threebod/mecanum_jog/README.md

# 麦克纳姆轮串口点动测试例程

## 当前代码检查（2026-10-13）

本次整理保留当前机构、路线和视觉参数，物理参数已由项目负责人确认完成实机验证。
离线检查通过：Keil 构建 0 错误、0 警告，配套上位机完整 CTest 38/38，MaixCAM Python 测试 52/52，
K230 Python 测试 40/40，以及固件契约、机构时序、云台运动和障碍停车独立测试。
本次未连接、烧录或驱动硬件；后文历史验证记录对应各自版本，以本节作为当前提交的软件检查结果。
构建输出、日志、相机 ZIP、Python 缓存和本地 Wi-Fi 配置不提交。K230 部署前将
`camera_code/K230/wifi_config.example.py` 复制为 `wifi_config.py`，填写本地 Wi-Fi 信息后上传开发板。

当前自动取放机构速度：水平轴 1000 RPM；云台夹持时峰值 220°/s（平滑起停），空载时 250°/s（等步长转动）。夹持状态按夹爪目标角度推定，张开至 90° 视为空载。`turretDps10=2200`，空载速度由主控切换为 2500；上位机云台输入上限同步为 2200，平台仍为 1800。动作文件 `夹取.json`、`放置.json`、`放置_升降600rpm无等待.json`、`10_粗加工回收xiugai.json` 已同步水平与云台参数。此段为当前速度，后文旧速度记录仅供历史对照。

新增独立“区域记忆避障跑图”：`avoid start 1|2 10..250`，上位机默认 30 RPM。K230 检出后停车确认、按区域记忆封路、退回并重新规划。到扫码点朝右停车扫码，收到结果后继续两轮底盘路线，不执行取放；K230 扫码后保持运行。部署、区域及标定见 [AVOIDANCE_TEST.md](AVOIDANCE_TEST.md)。

已加入地图两轮底盘路线、指定安全航点移动和 IMU 闭环旋转，支持蓝牙 `route auto 1|2 [rpm]` 连续跑完整路线、`route step 1|2 [rpm]` 逐点测试、`nav init 1|2` 初始化估计位置、`nav goto X Y [rpm]` 移动到安全航点、`turn L|R 90` 单独旋转和 `!` 急停。启动运动前先发 `arm`。首次使用请阅读 [ROUTE_TEST.md](ROUTE_TEST.md)。路线和导航位置均为速度积分估计，尚未接入地面定位、随机避障、扫码及抓取流程。

已增加同步距离测试、IMU 航向保持、单轮验向和四轮 CAN 查询。完整新增命令、接线及落地测试步骤见 [STRAIGHT_TEST.md](STRAIGHT_TEST.md)。原有命令保留；新版本运动期间会拒绝叠加运动命令，等待测试窗口结束或先停车。

本例程用于架空状态下检查 1～4 号麦轮电机的编号、方向和四轮联动。工程复用 `yyb_stm32` 的 STM32F407ZG 标准外设库、CAN 和 Emm_V5 驱动，不会修改参考工程。

## 硬件与通信

- 主控：STM32F407ZG，系统时钟 168 MHz
- 电机总线：CAN1，PA11(RX)、PA12(TX)，500 kbit/s
- 蓝牙命令串口：UART5，PC12(TX)、PD2(RX)，115200、8N1
- 淘晶驰 T1 串口屏：USART6，PC6(TX) 接屏幕 RX、PC7(RX) 接屏幕 TX，115200、8N1，3.3 V TTL 并共地
- 麦轮电机地址：1、2、3、4；辅助机构诊断地址：5、6
- 舵机 2/3/4：PA1/PA2/PA3，对应 TIM2_CH2/CH3/CH4

HC-05 与核心板交叉连接并共地：

| HC-05 | STM32F407ZG |
| --- | --- |
| TXD | PD2 / UART5_RX |
| RXD | PC12 / UART5_TX |
| GND | GND |

HC-05 数据串口应配置为 115200、1 停止位、无校验，常见完整 AT 固件对应 `AT+UART=115200,0,0`。模块 RXD 必须使用 3.3 V 逻辑电平；若底板没有输入分压，不要输入 5 V 串口电平。

> 软件停止不能替代硬件急停。首次运行必须架空四个轮子，确认人员可以立即断开电机电源，并且不要直接运行完整整车流程。

## 使用方法

使用 Keil MDK 打开 `MecanumJog.uvprojx`，通过有线下载器编译并下载。配对 HC-05 后，在电脑或手机上打开对应的蓝牙串口。命令除 `!` 外均以回车或换行结束：

上位机“路线编辑”页使用新增的 `move W|S|A|D 距离mm RPM` 相对移动指令，
距离 1～2400 mm、速度 10～250 RPM，横移受 `route tune` 的横移速度上限限制。
方向相对当前车头，保持启动时 IMU 航向，沿用现有前后／横移比例进行速度积分估算。
启动与完成分别反馈 `MOVE RUN dir=... distance_mm=... rpm=...` 和
`MOVE DONE dir=... distance_mm=...`；完成只停止底盘，不清除机构初始化。
单独转向成功也保留机构初始化，但会使旧地图导航位置无效。
`mech status` 增加 `MECH SERVOS gripper_mdeg=... platform_mdeg=... turret_mdeg=... moving=...`，
供路线动作组核对初始状态。故障、手动停止及心跳超时仍停止并清理全局运动状态。

```text
arm       授权下一次运动命令，执行一次后自动取消授权
disable   停止并失能 1～6 号电机，无需 arm
motor N D 5/6号电机按方向0/1短点动，必须先 arm
auxmove N D R A 5/6号电机按相对距离移动，D单位0.1mm，必须先 arm
cancheck N 查询1～6号电机CAN状态并打印原始回包，无需 arm
servo N A 将舵机 N 移到电气角度 A，无需 arm
W / w     前进点动
S / s     后退点动
A / a     左移点动
D / d     右移点动
X / x     停止 1～6 号电机和舵机缓动，并取消授权
stop      停止 1～6 号电机和舵机缓动，并取消授权
!         无需回车，立即请求电机与舵机缓动紧急停止
help      显示命令帮助
nav init 1|2       以对应启停区初始化估计位置，要求空闲且 IMU 新鲜
nav goto X Y [rpm] 沿安全通道移动到指定坐标，速度10～250 RPM，默认200，必须先arm
nav status         查询导航有效性、估计位置和目标
route tune F L T [V]   空闲时设置纵向/横向比例、转向及横移上限；比例5000～15000，转速10～250 RPM
route scale N      兼容命令：仅设置横移比例
route rawpick 1|2 [rpm]  首轮原料区停车，按绿、黄、浅蓝顺序夹取入槽，必须先arm
task CCC+PPP+CCC+PPP    下发两批颜色顺序和位置，运行中拒绝修改，重启后失效
pid get            读取导航/路线平移航向 PID 的 RAM 当前值
pid set KP KI KD   停车后设置航向 PID，三个参数均为实际增益的100倍
vision align material N  对准颜色1～6的物料，必须先arm且已完成视觉标定
vision sample material N ID  只读指定颜色1～6的稳定中心；ID为1～65535，不移动或夹取
vision scale material F R  空闲且arm后设置物料前后、左右比例；F/R为毫米/像素乘1000，范围50～2000
vision pick material N   底盘静止时识别颜色N，成功后执行单件夹取动作；必须先arm、初始化机构并确认当前姿态为(0,0,2720)
vision align ring N      对准物理圆环1～3，必须先arm且已完成视觉标定
vision scale ring N F R  空闲且arm后设置圆环N的前后、左右比例；F/R为毫米/像素乘1000，范围50～2000
vision pause/status      停止并接管/查询视觉状态
vision jog F R RPM       车体前/右方向各-20～20mm，10～30RPM，必须先arm
mech init H L T    人工确认当前机构姿态，单位为0.1 mm/0.1°，无需arm
mech pose H L T HR HA LR LA TS  移动到机构姿态（升降0～1500 ×0.1 mm），必须先arm
mech status        查询机构估计姿态
```

`mech pose` 和 `auxmove` 对 5/6 号升降、平推电机的可设上限为 1200 RPM、加速度参数 200，与上位机动作录入和定距调试界面一致。现有自动取放动作表仍保留原速度；高转速应先在架空、可急停条件下分轴测试，实际到位仍需人工核对。

`nav goto` 接受地图范围内、车体按 300×300 mm 计算后仍满足净空的任意整数坐标。规划器会从当前估计位置接入静态安全航点图，并以水平或垂直安全线段到达目标；障碍区、边界净空不足或无法通过安全通道到达的坐标会返回 `ERR NAV:`。地图点击仍可吸附既有安全航点，也可在上位机输入精确坐标。导航运行期间约每 200 ms 输出一次 `NAV POS`；正常完成输出 `NAV DONE`。`stop`、`!`、心跳超时、CAN/IMU 故障以及其他手动底盘动作都会使估计位置失效，之后必须把车放回启停区并重新执行 `nav init 1|2`。

`route start`、`route step`、`route auto`、`route rawpick`、`route mission`及PC9启动分别使用 `route_plan.h` 的 `routeDistanceZone1` 和 `routeDistanceZone2` 两套完整距离表：每段仅保存向上/向右的有符号距离、出发朝向、到达朝向和工位事件，不使用全图航点。距离按下发转速、时间和前进/横移标定比例估算；IMU负责朝向，视觉仍负责工位局部对准。上位机显示每段已走/目标距离，不用距离消息更新地图位置。两套表各自包含完整20段的距离、朝向和工位事件，`routeDistanceLeg` 只按起点选择对应表，不再叠加共用表或起点修正；修改某套的距离和转向只影响该套。底层运动控制与取放流程共用。独立的人工 `nav goto` 功能仍使用地图导航，与两轮距离任务分开。

`route auto 1|2 [rpm]` 是仅控制底盘的完整跑图命令，依次经过二维码区、第一轮原料/粗加工/暂存、第二轮原料/粗加工/暂存并返回对应启停区。按固定的方向、距离和朝向逐段执行，每段从0累计已走距离，不读取或重置全图X/Y。运行时约每 200 ms 输出 `ROUTE DIST`（段号、地图方向、目标距离、已走距离、朝向和状态），到达作业点输出 `ROUTE STAGE`，结束输出 `ROUTE DONE mode=DISTANCE`；它不会执行扫码、抓取或其他机械动作。

路线与导航按车头朝向判断车体横移并应用横移转速上限：车头朝上/下时沿地图X移动属于横移，朝左/右时沿地图Y移动属于横移。两轮原料区到粗加工区均先转为车头朝下，向前直行到站后转为车头朝右；两轮完整取放任务均将取料微调的反向补偿与沿地图向右退出50毫米合成一次移动。该段直行使用前进比例及请求速度，不受横移上限约束；其他横移默认上限150 RPM，低于上限的请求速度保持原值。

`route rawpick 1|2 [rpm]` 是原料区联调命令。出发前确认机构实际位于水平0、升降0、转台65°、夹爪闭合35°、平台1槽，并执行 `mech init 0 0 650`；核对物料对准方向和抓取锚点后发送 `arm`、`vision scale material 640 673`，再发送 `arm` 和路线命令，也可在上位机“场地定位”页点击“路线取料联调（RAW_1 三件）”。未应用物料比例时路线拒绝启动，比例仅保存在 RAM。路线到达 `RAW_1`、完成转向后停车；依次抓取绿(4)、黄(2)、浅蓝(6)，分别放入平台1、2、3槽。每件先将水平轴收至-770、转台到272°并保持升降0，再同时开始相机识别与升降轴下降500（50 mm）；升降运动结束并重新确认目标后才夹取，相机按v1.0.9采用附件六色阈值及原面积范围，取最大色块，取消物料质量及贴边筛选；连续10个有效帧且各轴中心波动不超过8像素即稳定，无最低500ms等待，回传这10帧中心中位数及实际颜色。每轮先用任意颜色1～6中面积最大的物料校准，首次及后续均以画面X轴±14像素为范围，Y轴换算本次夹取的水平轴补偿；X超限时只按原X映射修正底盘，停稳300ms后重新请求复检。首次对准完成后才等待绿色，重新确认连续10帧静止且X轴进入范围，一轮合格结果即可夹取；后两件依次等待黄色和浅蓝色，同样按X轴±14像素确认，X超限则再次校准；每件动作完成后才标记该颜色已收集。目标移动或识别不稳定时继续等待，不调整车辆或执行夹取；通信超时、机构或IMU/CAN故障会停止流程。第三件动作结束输出 `ROUTE RAWPICK state=DONE color=0 slot=0`，车辆仍停在 `RAW_1`，人工检查后发送 `route next` 或点击上位机“确认并继续路线”才继续；三件未完成时拒绝继续。`stop`、`!` 或故障后不能直接续行，须核实机构位置并重新初始化。对准只依据物料中心，不验证夹持结果；每段已走距离仍按转速和时间估计，没有地面距离反馈。

`route mission 1|2 [rpm]` 是独立的两轮取放任务，保留上述两个联调命令的行为。上电自动向云台（舵机4）输出65°指令，同时向夹爪（舵机2）输出闭合35°指令；按用户确认的上电物理零位，固件自动初始化水平0、升降0、转台65°，同时将平台指令到26°并准备PC9离线启动；默认200 RPM，物料保持前后640、左右673，圆环2采用实测前后1111、左右1143的比例。到第一次取料区RAW_1后，准备动作将空载云台以200°/s匀速转至272°并将水平轴收至-770，完成观察姿态后，同时请求识别物料和下降升降轴至500（50 mm），实际抓取动作会先张开夹爪至90°。升降未结束时继续识别，结束后重新确认目标才启动夹取。后续伸出保持升降500，不再先回到0再下降，抓取后仍抬升至0；夹取动作表共12步，`动作组/夹取.json`同步更新。跑图入口允许夹爪闭合35°或张开90°，平台仍须为26°。兼容已初始化为272°的启动姿态；第二轮仍使用原272°姿态。通过上位机点击“开始两轮完整取放”时，会先下发任务码并等待对应的TASK SET确认，再依次指令夹爪90°（270°/s）、平台26°，等待舵机到位，再分别应用物料默认比例640/673和视觉页当前圆环2比例，收到两次主控确认后才授权发送任务命令；直接用串口发送 `route mission` 时无需预先发送任务码；可使用上电零位、舵机和视觉比例准备，启动前仍需 `arm`。舵机角度检查只依据已发指令，不是实物位置反馈。路线在二维码点至少停稳1秒，并持续等待合法四组任务码；K230扫码结果通过USART3接收，首个合法码决定两轮取放顺序与放置位置，同时转发给上位机和串口屏。主控缓存本次上电或本次任务接近扫码站前收到的首个合法扫码结果，兼容K230单次发送后停止；到站后采用并消耗缓存，至少停车1秒后继续。非法码不覆盖缓存，任务停止或结束清除缓存，不复用上一任务。第一、三组任务码分别决定两批的颜色和抓取顺序，三件依次放入平台槽1/2/3。每轮先用任意颜色1～6中面积最大的物料校准，无需等待该批首件颜色；首次及指定颜色阶段均采用X轴±14像素范围，Y轴只补偿水平电机的夹取位置。任意颜色对准完成后按任务码顺序请求指定颜色，每件重新确认连续10帧静止且X坐标进入范围，一轮合格结果即可夹取；超限时按标定换算完整移动，停稳300ms后以新token复检，最多12次修正。物料和圆环识别不设总等待时间：未找到或未稳定时持续等待并重新请求，圆环还检查质量；直到识别满足条件或人工停止。摄像头通信仍保留单次请求1800 ms、连续三次无回包停止的故障检查；累计微调距离不设上限，最多12次迭代限制保留。从取料区前往粗加工区的向下连续路段：两轮均为1720 mm；两轮均走左侧通道，下移结束转向右再前进860 mm到粗加工区。每段从0独立累计已走距离。两次粗加工区先将水平轴收至-770，停稳后用圆环2视觉对准，再执行取自 `动作组/放置_升降600rpm无等待.json` 的三件放置动作（按文件内容使用升降1000 RPM、加速度200、水平500 RPM、加速度200、转台180°/s，无额外等待），三件放置深度均为1300（0.1 mm），第三件松开夹爪后，保持原位直接夹紧，再抬升开始回收，不再先抬升再下降；三件全部放置后先在最后一件所在环抬升，再按该批任务码顺序回收三件，以相同速度和对应落点1300/1300/1300（0.1 mm）取回到各自原料盘槽，全部回收后先抬升并将水平轴收回至0，夹爪随水平轴撤回，再将转台直接转回65°；两轮暂存区同样先将水平轴收至-770；第一轮停稳后用圆环2视觉对准，第二轮优先对准圆环中心并跳过数字识别，多个圆环时选择最靠近第一层中间指定颜色物料中心的圆环；首次识别失败再对准该物料中心（沿用圆环2的ROI、锚点和比例，须实测物料高度带来的偏差），成功后才用同一组三件放置姿态，第一轮三个落点的升降深度统一为1300（0.1 mm）；两轮粗加工及两层暂存均按对应批次任务码的物料顺序放置，每次依次从平台槽1→2→3取料，第一轮粗加工和暂存使用第二组位置，第二轮粗加工使用第四组位置，第二轮暂存按第二批颜色匹配第一层同色物料所在圆环；转台角度306.5°/265.7°/232°分别对应圆环1/2/3，三个落点统一为650（0.1 mm），较第一层少下降65 mm。两轮原料区均记录视觉对准相对于对准前停车位置的累计前后及左右位移；第三件放入平台松爪后，先抬升，随后直接将机构收回至水平0、升降0、转台65°，不再中途转到272°；底盘保持停车，等待转台到位后才报告取料完成；后续按现有路线继续。两轮取料后只将视觉对准累计位移中的地图上下分量反向归位，以15 RPM下发并输出RAW_EXIT_VERTICAL阶段；无上下偏移时直接继续，不再额外右移50 mm。左右归位量合并到后续沿地图向左830 mm的路段：取料时车头朝左，实际左移距离为830 mm减去累计车体前进偏移（按整数毫米取整）。左移后停车转为车头朝下，沿地图向下1720 mm（本次减少20 mm），再停车转为车头朝右，沿地图向右860 mm到对应轮次粗加工区。两轮均取消额外右移50 mm。回位依赖已发位移指令的累计估算，没有独立位置反馈，实际精度须实测。粗加工和暂存区在视觉对准成功后，以当前位置作为该区域标准位置，作业结束收回机构后不再进行底盘微调回退，直接执行下一段原定相对路线；粗加工到暂存区先保持车头朝右，直接沿地图向左（X负方向）连续移动860 mm，走完后停稳转为车头朝地图下方（地图后方），随后沿地图向上后退850 mm至暂存区，走完后保持朝下直接作业，机械臂位于车体右侧、面向地图左侧；两轮均生效，视觉微调不计入下一段距离，后续距离从各区域完成作业的位置重新累计。扫码区完成扫码后，两套路线均先原地将车头从朝右转为朝上，再沿地图向上直行：启停区1为830 mm，启停区2为825 mm；走完停稳后再将车头转为朝左；转向停稳后到第一次取料区：启停区1出发第一段左移为200 mm，扫码后到第一次取料区左移从930 mm减少至900 mm，两段合计左移1100 mm；启停区2扫码后到第一次取料区同样向左走900 mm，直接开始取料，不再在物料区转向，也不额外后退100 mm；后续相对距离保持原值。第一轮暂存返回第二次原料区RAW_2时，先保持车头朝下、沿地图向上连续移动：启停区1出发为880 mm（较原840 mm累计增加40 mm），启停区2出发为850 mm（仅区2较此前840 mm增加10 mm），走完停稳并转为车头朝左，再沿地图向右连续移动850 mm（保留原有向右多走50 mm），保持朝左开始第二轮取料；抵达后按下一段独立距离继续执行。取料、粗加工放置与回收、暂存放置的物料平台速度统一为180°/s，平台转动与机构动作并行，只在夹爪下降到平台取放前等待平台指令转动完成，新平台转动不会覆盖尚未完成的上一条转动。固件输出 `ROUTE MISSION phase=... station=...`；圆环或第二轮暂存中间物料未识别、未稳定时持续重新请求，圆环还检查质量；不盲目移动；通信超时、对准超限、动作、回位或传感器故障会取消任务，不能原地续跑。取回及暂存动作由现有姿态推导，必须先按台架分段验证电机方向、机械净空、夹持和急停，之后才可低速运行整圈；动作完成消息不代表实物取放成功。

扫码结果也会从 USART6 发往淘晶驰 T1。按 `test/lcd_ttl` 的测试界面，在屏幕工程的 `page0` 页面创建文本控件 `t0`，将 `page0` 设为启动页、项目字符编码设为 UTF-8、屏幕波特率设为 115200，并给控件足够的字符容量和字库。仓库目前只有 `test/lcd_ttl` 的 MCU 测试程序，没有可烧录的屏幕 HMI 工程，屏幕侧仍需在淘晶驰编辑器完成上述设置。主控收到 `QR:<内容>\n` 后发送 `page0.t0.txt="<内容>"`，末尾是三个字节 `FF FF FF`；结果同时用于扫码点的四组任务码校验和任务选择。若沿用只支持 GB2312 的屏幕工程，ASCII 内容可以显示，中文 UTF-8 内容需要先把屏幕工程改为 UTF-8。二维码内的引号、反斜杠和 `FF` 字节会在屏幕文本中替换为 `?`，上位机收到的原始结果不变。须在实机确认屏幕页面、控件名、波特率和供电电平。

完整四组任务码在 `t0` 中固定分两行显示，第一行为前两组及末尾加号（如 `156+123+`），第二行为后两组（如 `516+231`）。主控只在发给屏幕的文本中插入 CR/LF，扫码缓存、上位机日志和任务解析仍使用原始15字符任务码。屏幕 `t0` 的宽高需容纳两行大字，字库需包含数字与加号。

同一屏幕页面还需创建文本控件 `t1`、`t2`，分别显示 `正确抓取数：N` 和 `正确放置数：N`；三项控件均设为全局，`t0.txt_maxl` 建议48，`t1/t2.txt_maxl` 建议32，UTF-8字库须包含数字、加号及计数文字。主控上电和成功启动新的两轮完整任务时清零计数，在对应夹爪动作完成后逐件更新，停止、故障取消或任务结束时保留已有计数。按用户确认的动作完成口径，原料抓取和粗加工回收计入抓取，粗加工及暂存区落料计入放置，平台中转及手动调试动作不计；完整两轮为抓取12次、放置12次。当前没有夹持或落料成功反馈，屏幕文字沿用比赛界面，但这些数值只代表动作完成，不能证明实际取放正确。任务码继续由 `t0` 显示，比赛中需持续可见，数字实屏字高应至少12毫米；字体、排版和实机显示需在屏幕工程中确认。

若取料路线启动时报告机构姿态错误，先发送 `mech status`：`MECH INVALID` 表示需要在人工确认实际姿态后重新初始化；`MECH POS` 的 `h/l/t` 必须为 `0/0/650`（也兼容原来的 `0/0/2720`）。舵机仍在运动时等待 `SERVO DONE` 后再试。不要为了通过检查，把未知实际位置直接声明为初始姿态。

导航/路线平移航向 PID 可在上位机“临时调试”页读取和写入，也可用 `pid get`、`pid set 200 25 12`。Kp 范围 0～10.00，Ki/Kd 范围 0～5.00，纠偏输出仍限于 ±12 RPM；写入时底盘及机构必须停稳，固件会回报当前值。参数只保存在 RAM，复位后恢复 2.00/0.25/0.12。平移期间约每 200 ms 输出 `PID TRACE target_cdeg=... actual_cdeg=... output_rpm=...`，上位机据此绘制目标/实际航向与纠偏输出曲线。原地转向和 `straight` 命令仍使用原有控制器。

`pid move A|D 2000 20` 用当前航向作目标，以导航航向 PID 限时向左/右横移并输出相同的曲线数据；需先 `arm`，时间 1000～5000 ms、速度 10 RPM 至当前横移上限。到时会停车，移动距离不作测量。上位机“临时调试”页提供左右按钮和时间、速度设置。

粗加工回收保留 `动作组/10_粗加工回收xiugai.json` 的单件抬升、转向和平台放回姿态，完整任务按任务码顺序生成，共37步，两轮均生效。
圆环角度306.5°、265.7°、232°分别对应物理圆环1、2、3。圆环1水平目标位置为55（5.5 mm），较此前向前0.5 mm，角度306.5°；圆环2角度从266°减少0.3°至265.7°；圆环3水平目标位置为435（43.5 mm），较此前向前0.5 mm，粗加工放置、回收及两层暂存放置同步使用新落点。粗加工放置、回收及两层暂存放置均按对应批次任务码的物料顺序执行，平台槽依次为1→2→3。粗加工三件全部放置完成后，先在最后一件所在环原位抬升至0，再移动到任务首件所在环下降夹取，三件均返回原平台槽。每件抬升后先保持当前水平位置将云台转向132°，再将水平轴收至该轮的平台放回位置；三个平台放回深度均为300（0.1 mm）。第一轮三件的平台水平位置为-450（较此前-500少回退5 mm）；第二轮三件按指定位置-470（-47 mm）放回。下降至300、松爪及松爪后抬升阶段均保持对应轮次的水平位置。下降到平台前仍等待平台转动完成。
结束时先在132°收回水平轴至0，再转回65°。入口为任务第三件放置后原位，水平位置和云台角度由该件目标环确定，升降1300、夹爪张开。

取料、圆环及码垛观察的水平位置统一从-720再调整为-770，即再回退50（5 mm），较原-500累计回退27 mm；竖直坐标不变。相机让位后抓取和放置仍使用原来的绝对目标坐标，不把平台取放位置整体平移。

## 上位机任务码

任务码为 `CCC+PPP+CCC+PPP`，严格四组三位数。第一、三组为两批的颜色和搬运顺序；第二组为第一批在粗加工区和暂存区的位置，第四组仅为第二批在粗加工区的位置，每组必须为1、2、3的排列。第二批暂存按第一层颜色位置同色码垛，不使用第四组；两批颜色须能一一匹配，否则在码垛前停止并报告 `mission_stack_colors`。颜色：红1、黄2、蓝3、绿4、黑5、浅蓝6。圆环1的角度最大（306.5°），其次是圆环2（265.7°）、圆环3（232°）。

例如 `156+123+516+231`：第一批红、黑、浅蓝依次进入平台槽1/2/3，粗加工放置、回收及第一层暂存均按环1→2→3执行；第二批黑、红、浅蓝依次进入槽1/2/3，粗加工放置和回收均按环2→3→1执行；第二层暂存按黑、红、浅蓝顺序，依次码垛到同色的环2→1→3。所有阶段均依次选择槽1→2→3。暂存第二批使用第二层的650深度。粗加工回收保持原槽与物料对应关系。

上位机“场地定位”页填写任务码后点击“开始两轮完整取放”，会先发送 `task 156+123+516+231`，仅在收到相同任务码的 `TASK SET code=156+123+516+231` 后继续舵机、视觉比例和路线启动准备。非法格式或运行中修改返回 `ERR TASK`，不覆盖当前有效任务。任务只存在RAM，启动时清除上位机任务的有效标志，但保留本次收到的合法扫码缓存；到扫码点时采用并消耗缓存，若无缓存则等待新合法扫码码后继续。扫码确认覆盖预先下发的任务，不使用上位机任务作为扫码失败时的后备。

## PC9按键启动完整任务

PC9配置为GPIO输入、内部上拉；按键一端接PC9，另一端接主控GND。按下为低电平，按下和松开均进行30 ms消抖。短按不足1秒并松开启动启停区1；长按满1秒立即启动启停区2，继续长按和随后的松开不重复启动。上电时按键已经接地不会启动，须先松开再按；运行中的按键事件不会排队到任务结束后执行。

上电后无需连接上位机：水平/升降轴按用户确认的物理零位初始化为0，云台指令65°、夹爪35°、平台26°，物料和圆环2比例采用前后640、左右673，默认200 RPM。舵机指令运动结束后按PC9即可启动完整任务，到扫码点等待四组任务码（例如 `156+123+516+231`）。IMU必须新鲜、CAN必须健康，按键仅授权本次任务启动。

终端 `arm`、`route button <rpm>` 仍可重新准备PC9并选择10～250 RPM速度；上位机仍可覆盖视觉比例。PC9准备及按键启动任务无需主机心跳；上位机直接发送 `route mission` 启动的任务仍保留现有心跳保护。停止、失能、急停、CAN故障会取消准备，运行中IMU/CAN/视觉通信与动作故障保护保持。任务结束或中止后不会自动重新准备；须核实实际姿态、恢复零位后重新准备或重新上电，禁止原地盲目续跑。

软件检查已覆盖GPIO上拉设置、消抖、短／长按分区、启动前无底盘使能、长按不重启、上电按住、启动状态变化和毫秒计时回绕；接线、按键输入电平及两个启停区的实车完整流程尚未验证。

## 回启停区与颜色反馈（2026-10-08）

第二轮暂存结束后不再先进入右侧通道。启停区1先保持车头朝下、沿地图向上880 mm，停稳转为朝右，再向右前进1700 mm、保持朝右向上横移170 mm、向右前进150 mm。启停区2先保持朝下、沿地图向下850 mm，停稳转为朝右，再向右前进1700 mm、保持朝右向下横移200 mm、向右前进150 mm。两套路线保留四段距离与顺序，分别返回原启停区，结束时车头朝右。每段独立累计距离，实机净空和停车位置须现场验证。

取料准备和等待阶段反馈当前指定颜色及槽位；夹取和单件完成反馈实际颜色及槽位。三件完成后转台回到65°并等待到位，随后反馈 `ROUTE RAWPICK state=DONE color=<该批第三件颜色> slot=3`，原料联调仍须人工确认后继续，完整任务自动继续。物料请求的 `value[6]` 为允许颜色位掩码（颜色N对应位N-1），结果 `value[5]` 为实际颜色；旧相机回传未知颜色时主控只等待，不猜测槽位。STM32与MaixCAM2程序必须同步更新；本次未改动人工确认版路线JSON。

实机验证先检查方向、急停、机构净空，再按取料、粗加工、暂存和回程分段低速测试。记录首次修正前后偏差和补调次数，检查任意颜色可用于首次对准、任务指定颜色超差会重新对准、非当前指定颜色不会触发运动或抓取，以及任务槽位映射；软件测试通过不代表实物夹取或一次到位已验证。

## 视觉微调

取料区坐标校验：画面X偏差 `du=u-160` 保持现有±14像素容差，范围内底盘不动，超限只沿原X映射修正底盘并停稳复检。画面Y偏差 `dv=v-120` 不再驱动底盘，按物料Y比例 `R` 换算水平轴：`补偿(mm)=-R×dv/1000`（R为毫米/像素乘1000），`夹取目标(0.1mm)=-200+round(-R×dv/100)`。例如R=673、dv=+35时目标为-436（-43.6mm），画面偏下减少伸出。只使用升降结束后、当前指定颜色的最新稳定样本；首次任意颜色对齐不执行抓取补偿。补偿应用于夹取伸出、夹紧后抬升，以及抬升后转向平台时保持的水平位置；平台放回坐标和末尾复位保持原值，各件独立计算。目标超过水平轴-122.0～65.0mm范围时输出 `PICK_HORIZONTAL_RANGE` 并停止，不夹取、不截断位移。日志 `VISION PICK OFFSET` 输出dv、补偿及目标（单位0.1mm）。仅两轮任务及route rawpick的取料区生效，单件固定夹取测试、普通视觉对准、圆环和暂存流程保持原逻辑。方向按用户确认，实机效果仍需低速验证。

上位机也支持物料比例自动标定：在“视觉微调”选择物料及固定颜色，先将机构置于实际取料观察姿态，保持该颜色的单个物料静止可见，确认各方向20 mm净空后点击“自动标定物料比例”。机构姿态须人工准备，程序不夹取；前后、左右各往返20 mm（15 RPM），每步停稳300 ms。新增 `vision sample material COLOR ID` 只读采样，回包包含样本ID和颜色，稳定性及指定颜色检查通过才采样，质量值仅作诊断。比例经主控确认后独立应用，完整任务不会覆盖成默认物料比例；断电恢复默认值。此功能需要配套更新主控固件，摄像头程序无需因本功能更新，尚未实机验证。

上位机支持圆环 2 自动标定：在实际识别姿态下，以 15 RPM 前后及左右各往返 20 mm；每次移动完成停稳 300 ms，
再通过 `vision sample ring 2 ID`（ID 为 1～65535）读取稳定中心。主控回复
`VISION MEASURE id=... ring=2 token=... du=... dv=... quality=...`，不使用旧比例、不执行视觉矫正。
采样结束为 IDLE，可执行带 `arm` 的 `vision jog` 探测；最后一次回位采样后，上位机核对方向、往返偏差和两轴耦合，
用往返像素变化平均值换算两轴比例，再通过 `vision scale ring 2 F R` 应用，必须收到对应值确认才完成。
采样保留相机 token 校验及质量/稳定性检查；异常或超时停止，标定值只保存在 RAM。
采样连续 3 次未确认才停止，每次重试使用新相机 token；上位机按往返均值检查两轴耦合，并保留 3 像素回位门槛。
圆环2正式默认比例定义在 `vision_defaults.h`：1.111 / 1.143 mm/像素；固件离线上电及上位机圆环2输入使用同一默认值，物料保持0.640 / 0.673。在线标定可覆盖本次上电参数，重启恢复正式默认值。相机坐标仍为 320×240 协议坐标，比例变更本身不需要更新相机程序。自动标定实机效果尚未验证。

MaixCAM通过UART4连接：STM32 PC10(TX)接MaixCAM2 A22(RX)、PC11(RX)接MaixCAM2 A21(TX)，9600、8N1、3.3V逻辑并共地。部署 `camera_code` 整个目录并运行其中的 `main.py`。UART5仍用于上位机，USART2仍用于IMU。

自动微调按“停车识别—完整修正—停稳复检”执行；取消20mm拆步，首次直接执行标定换算出的完整位移，复检超出当前容差时重新补调。前后及左右位移绝对值累计之和不设上限，最多12次，取料首次任意颜色校准、修正后及后两件夹取确认统一采用X轴±14像素范围，一轮静止结果即可确认；X超限时重新对准，Y轴换算水平轴夹取位置，不驱动底盘。圆环及暂存对准仍允许各5mm误差，连续两次确认满足阈值才完成；完整修正不会因累计移动超过100mm而停止或截断。相机帧使用30字节CRC协议和请求token，过期、重复、无效或非稳定结果均不能触发运动。`stop`、`!`、心跳超时、IMU/CAN异常和`vision pause`都会停止闭环。视觉或人工小步会使地图积分位置失效，之后必须重新`nav init`。

上电离线准备会启用物料和圆环2的当前比例；圆环1、3仍须手动标定。圆环可在上位机“视觉微调”页分别调整前后、左右毫米/像素比例，再点击“应用当前圆环比例”；主控确认后，该圆环以画面中心 `(160,120)` 为目标，按 `前后=-F×du/1000`、`左右=-R×dv/1000` 换算。两个轴的对应关系与符号来自圆环2的连续移动日志，尚未通过纯方向点动独立验证；当前未补偿轴间交叉影响。圆环2默认采用用户实测的 `F=1111`、`R=1143`；圆环1、3界面初值仍为 `F=640`、`R=673`，并非圆环1、3的独立实测值，只适合低速小步验证；请先核对车体方向、急停和每步位移。物料比例也暂参考这组数据，须核实物料相机视角下的方向、比例以及画面中心是否对应实际抓取点；最终应按 [camera_code/README.md](camera_code/README.md) 做物料九点标定，必要时修改 `vision_config.h` 中的 ROI、锚点及交叉项。在线修改的比例只保存在主控 RAM 中；重启恢复离线默认比例：物料前后640、左右673，圆环2前后1111、左右1143。未应用时固件返回 `VISION ERROR reason=CALIBRATION_INVALID` 或拒绝启动取料路线。每个目标仍须保证相机能唯一识别。不得用零矩阵解锁。

单件原料夹取测试使用上位机“视觉微调”页选择颜色，再点“识别指定颜色并夹取”（或发送 `arm`、`vision pick material N`）。底盘须已停车且路线已退出；机构先人工放到 `动作组/夹取.json` 的初始姿态：水平0、升降0、转台272°、夹爪张开90°、平台位置1，并执行 `mech init 0 0 2720`。主控先把水平轴收至 -770（-77 mm），再同时请求相机稳定识别所选颜色和下降升降轴至500（50 mm）；升降结束并重新确认指定颜色的静止目标后才执行 `raw_pick_action.h` 中取自该 JSON 的固定单件动作表。测试时须人工将原料放在这套动作能夹到的位置；检测只确认颜色存在，不校验物料是否位于夹爪抓取点，也没有夹持力或抬起确认。`VISION STATE state=PICK_DONE` 只表示动作指令结束，须人工检查是否夹到。识别失败、超时、暂停或急停均不启动后续夹取；中断后机构位置失效，需人工核实再初始化。单件指定颜色测试命令保持不变；本版任务取料首次对准请求任意颜色，对准完成后的夹取阶段仅请求当前指定颜色；相机需支持现有允许颜色掩码及实际颜色回传。

地图移动距离仍是开环估算。`route_plan.h` 的 `ROUTE_FORWARD_SCALE` 与
`ROUTE_LATERAL_SCALE` 分别标定前后和横移。100 RPM、横移比例90%的6次中心点测试中，
车体右侧到场地右边界均值为103.9 cm（理论105 cm），因此默认横移比例改为90%。2026-10-14确认
`line W 500 120` 使用9.9脉冲/mm后实测约500 mm；正式程序按3200脉冲/转、理论轮周314.159265 mm
换算，纵向默认比例设为102.89%（3200 / 9.9 / 314.159265），用于路线、相对移动及视觉微调的前后位移。
上位机“临时调试”页同步采用102.89%。该结果来自前进120 RPM，后退和其他速度仍须复测。
当前路线和导航行驶默认200 RPM，横移默认上限为150 RPM，转向默认上限为230 RPM；路线和导航可设10～250 RPM；原90%横移比例取自100 RPM 测试，需按当前轮型和转速重新实测。更换地面、轮胎、负载或平移转速后必须重新实测。
原地转向参考 `yyb_stm32` 的两阶段PID：大误差采用KP=2、KI=0、KD=0.8，误差进入15°内采用KP=2、KI=0.05、KD=0.4，积分贡献限幅±7 RPM。按参考工程50 ms周期换算当前IMU采样间隔，同一IMU样本不重复积分或微分。加速保留90 RPM/s缓变，减速及时更新，反向纠偏先清除旧方向速度；进入2°误差后停车，保留3.5°退出阈值和200 ms稳定检查。参数为参考初值，超调改善仍需实机验证。
路线到达有任务的站点后，先按出发时保存的航向基准校正角度，再进入视觉微调或站点动作；即使方向编号不变也执行检查。到站校正要求误差连续保持在±1°内200 ms，最后一次IMU采样必须覆盖这段稳定时间，重复使用旧样本不能判定完成。超差重新调整，IMU失效或转向超时沿用故障停车流程。这里不发送陀螺仪归零命令；过渡点和手动转向保持原判定。±1°为本次软件目标，须实机验证能否稳定达到。

上位机“临时调试”页可发送 `route tune F L T V` 同时调整纵向比例、横向比例、转向上限及横移上限；旧的三参数命令保持当前横移上限。设置仅写入 RAM，重启恢复默认值。
运动期间会被拒绝；横移上限也用于 `pid move A|D`。

机构命令中的 `H/L/T` 分别是6号水平位置、5号升降位置和转台角度，单位均为0.1；
`HR/HA/LR/LA/TS` 分别是水平转速/加速、升降转速/加速和转台速度（0.1°/s）。
水平范围为-122.0～65.0 mm，升降为0～150.0 mm，转台为0～360.0°；水平电机速度
10～1200 RPM、加速1～200；升降电机速度10～2000 RPM、加速1～240，转台速度1～180°/s。移动期间约每200 ms输出估计的
`MECH POS`，完成输出`MECH DONE`。该位置没有传感器校验；停止、急停、心跳超时、
CAN故障或手动点动机构后会输出`MECH INVALID`，必须人工复位并重新执行`mech init`。

Qt 上位机选择 `mecanum_jog 文本协议` 后会每 250 ms 静默发送内部命令 `hb`。
固件收到首个 `hb` 后启用通信看门狗；若后续 1000 ms 未收到心跳，会停止 1～6 号
电机、停止舵机缓动并取消授权和路线，然后输出
`ERR: host heartbeat timeout; stopped`。从未发送过 `hb` 的手机或普通串口会话保持原行为。
该看门狗只能请求软件停车，不能替代断电急停。

舵机 2、3 的角度范围为 0～272°，舵机 4 为 0～360°。例如：

```text
servo 2 45
servo 3 90 1800
servo 4 180 1800
```

第三个参数为可选速度，单位是0.1°/s，范围10～1800；省略时使用1800，即180°/s。上电后 PA1（夹爪）输出35°指令、PA3（云台）输出65°指令，PA2（平台）在收到有效指令前不输出PWM。每个舵机的第一条有效命令会直接建立该通道的软件当前位置；同一通道后续命令按指定速度缓动，并在到达后返回 `DONE servo=<编号> angle=<角度>`。`X`、`stop` 和 `!` 会取消正在进行的舵机缓动，并保持当前位置的 PWM 输出。

云台通道4的后续运动采用五次曲线缓启动、缓停止，速度参数表示指令峰值速度；通道2、3保持匀速更新。带料云台运动时间按 `1.875 × 角度差 / 峰值速度` 计算，空载按 `角度差 / 200°/s` 计算并向上取整到20 ms，例如带料90°、180°/s需要940 ms。完成消息仅表示指令轨迹结束，未读取舵机实际位置。

取料、粗加工放置与回收、暂存放置及观察姿态的水平轴目标速度统一500 RPM，加速度参数200（按当前驱动公式约357 RPM/s）；短行程可能达不到目标速度，须实测机械净空、振动和抓取稳定性。升降轴在取料、放置、回收、暂存及观察姿态中统一为2000 RPM、加速度参数240，与参考工程一致。动作之间没有统一间隔：姿态动作在水平轴有位移时为该轴估算时间增加50 ms余量，再根据水平、升降、云台三者中最长的估算运动时间推进，不等待5、6号电机到位回包，不追加步进轴500 ms或云台100 ms余量；云台PWM缓停轨迹尚未结束时仍等待轨迹完成。没有电机到位反馈也会在估算时间结束后继续，`MECH POS` 和 `MECH DONE` 均不能证明步进轴实际到位。急停、心跳超时和CAN发送故障仍会停车并使机构位置失效。动作表的 `waitMs` 在完成后再追加，0表示没有追加等待；取料、粗加工和暂存流程均无额外固定等待，原暂存夹紧前500 ms等待保持移除。夹爪开合速度统一270°/s，仍须完成指令运动，平台180°/s转动与机构并行，但下降到平台取放前须等待平台指令转动完成。取料、暂存及观察姿态中原120°/s的舵机速度均提高到180°/s。4号云台在空载时取消缓启动、缓停止，以200°/s匀速转动；夹爪夹紧后按可能带料处理，恢复动作表原有的缓启动、缓停止轨迹，张开到90°后恢复空载模式。负载状态依据夹爪指令推断，上电闭合初始化按空载处理，没有夹持传感器。空载运动仍等待指令轨迹完成，姿态等待时间按空载转动与步进轴中最长时间计算；夹爪和平台保持匀速。所有舵机完成判断均为指令执行状态，没有实物位置反馈。`cancheck` 和单轴 `auxmove` 原有状态查询行为保持不变。

上电后发送一次授权再前进；运动命令会自动使能所需驱动器：

```text
arm
W
```

W/S/A/D 会消耗一次授权；再次发送 `W` 会被拒绝，必须重新发送 `arm`。测试结束可直接发送 `disable`。默认点动参数为 30 RPM、加速度 50、160 脉冲，四个电机使用同步位置模式启动。`line` 仅接受100、200、300、400或500 mm，转速范围为10～250 RPM；`straight` 转速范围仍为10～120 RPM。可用 `arm`、`line W 500 250` 重测250 RPM设置下的距离，当前距离比例仍为已在120 RPM验证的9.9脉冲/mm。

若要单独测试5号或6号辅助电机：

```text
arm
motor 5 0
arm
motor 6 1
stop
```

也可以按相对距离移动，正距离使用机构正方向，负距离自动反向。例如5号移动
20.0 mm、6号反向移动50.0 mm：

```text
arm
auxmove 5 200 30 50
arm
auxmove 6 -500 30 50
```

`auxmove` 参数依次为电机号、相对距离（0.1 mm）、RPM和加速度。5号单次范围
为-1500～1500，6号为-1870～1870，距离不能为0。固件没有位置传感器，范围限制
只约束单次命令，不能防止从当前位置撞到机械限位。

5、6号电机使用相同的保守点动速度、加速度和脉冲数，采用参考工程中单电机位置控制的立即启动方式，不发送同步启动帧。6号电机在参考工程中用于平推机构，首次测试必须确认机械限位并从安全位置开始。`X`、`stop` 和 `!` 均会停止1～6号电机。

若电机不转，先发送：

```text
cancheck 6
```

收到驱动器回包时，串口输出 `CAN RX motor N` 以及扩展帧 ID、DLC 和原始数据；300 ms 内没有回包时，输出 `ERR: motor N no CAN reply` 以及 STM32 CAN 的 `ESR/TSR` 寄存器值。`TX queued` 只表示固件已把运动命令交给 CAN 外设，不表示驱动器已经执行。

## 方向映射

| 车体方向 | 1号 | 2号 | 3号 | 4号 |
| --- | --- | --- | --- | --- |
| 前进 W | 反 | 正 | 正 | 反 |
| 后退 S | 正 | 反 | 反 | 正 |
| 左移 A | 反 | 反 | 正 | 正 |
| 右移 D | 正 | 正 | 反 | 反 |

这里的“正/反”对应 Emm_V5 的方向位 0/1 组合。当前四轮为 X 型安装，横移方向位与已实测通过的 `test/chassis_position` 一致；前后及原地转向方向位保持一致。

## 首次检查顺序

1. 只给主控和 CAN 收发器供电，确认串口出现就绪提示。
2. 上电云台会收到65°PWM指令、夹爪会收到35°闭合指令，先确认该角度的机械净空；步进电机不会自动运动。首次启用PWM无法知道舵机实际角度，不保证从实际位置缓动。
3. 未发送 `arm` 时发送 W/S/A/D 和 `motor 5 0`，确认均返回错误且电机不动。
4. 依次发送 `arm` 加 W、S、A、D，每次只观察一次低速点动并确认自动使能。
5. 分别发送 `cancheck 5`、`cancheck 6`，确认辅助电机地址和回包。
6. 舵机首次测试应卸除连杆，并从接近当前实际位置的小角度开始；舵机必须使用合适的外部电源并与主控共地。
7. 运动期间发送 `!`，确认 1～6 号电机停止且舵机停止继续缓动；测试结束发送 `disable`。
8. 若实际方向与表格不符，先核对电机地址、安装方向和驱动器方向配置，不要直接修改整车参考工程。

## 本地自动测试

在工作区根目录运行：

```powershell
& test/mecanum_jog/tests/test_mechanism_action_runtime.ps1
& test/mecanum_jog/tests/test_mechanism_timing_runtime.ps1
& test/mecanum_jog/tests/test_route_runtime.ps1
& test/mecanum_jog/tests/test_raw_pick_runtime.ps1
& test/mecanum_jog/tests/test_turret_runtime.ps1
& test/mecanum_jog/tests/test_contract.ps1
```

运行测试使用现有 E:\Qt\Tools\mingw1310_64\bin，不需要安装新库；各测试覆盖估算时间推进、无额外500 ms等待、平台并行、回收顺序及故障停车，其中时间测试编译实际机构启动和服务函数。契约检查验证工程目标、共享源码路径、串口参数和方向表；这些检查不能替代 Keil 编译或实机测试。

PC12/PD2 对应 UART5，只用于程序运行后的蓝牙命令通信。STM32F407 内置 ROM Bootloader 不支持 UART5，不要通过该 HC-05 连接烧录固件；烧录仍使用调试器或 PA9/PA10 上的有线下载连接。

当前使用的 `动作组/放置_升降600rpm无等待.json` 与 `动作组/10_粗加工回收xiugai.json` 的夹爪速度同步为2700（270°/s），与主控取料、放置、回收、暂存及上位机默认速度一致。

## 物料识别更新（v1.0.9）

相机安装包为 `camera_code/dist/maix-gongchuang_vision-v1.0.11.zip`，须配套重新编译、更新STM32固件。UART4仍为9600、8N1，30字节帧和CRC保持不变。物料的q仅用于诊断，圆环质量门槛及稳定规则保持原样。画面和 `VISION MATERIAL` 日志显示中心、相对屏幕中心像素偏差、直线距离、实际检测fps及本轮耗时，详见 `camera_code/README.md`。焦距已改变，原标定比例须实机重新核对，本次不修改矩阵或自动解锁。

## 第二轮码垛与扫码停止更新（v1.0.10）

第二轮码垛采用圆环优先、指定颜色物料备用。圆环不识别数字，多个候选按与中间指定颜色物料中心的距离选取；第一个无效圆环回包后切换到指定颜色物料识别。普通圆环流程保持数字2识别，标定、5mm容差、两轮确认、300ms停稳及12次修正限制不变。相机请求flags=0x04新增上述语义，selector携带备用颜色；固定帧长度、CRC和UART4波特率不变。相机与主控须配套更新。

K230运行camera_code/K230/扫码.py，首次二维码发送成功后结束程序，停止采图、显示并释放串口，不等待接收确认、不再重发。整板仍供电，下次需要手动重新运行或重新上电。直接部署camera_code/K230/中的扫码.py和qr_protocol.py，不打包ZIP；主控须已准备接收任务码。详见camera_code/README.md。

原料取料静止窗口自相机v1.0.11改为连续10帧，各轴波动容差仍为8像素；圆环及码垛规则保持原样。本次帧数修改仅需更新相机应用。
