threebod/mecanum_jog/camera_code/README.md

# MaixCAM 车辆视觉微调

K230 运行 `K230/避障跑图.py`，同目录上传 `avoidance_protocol.py`、`obstacle_detection.py`、`qr_protocol.py`、`camera_preview.py`、`obstacle_web.py`、`wifi_config.py`，共七个文件。同一入口接收到点请求后全画面扫码，扫码后继续运行；黑块只检测下方 2/3，门槛 2200，y=160 红线。无线浏览器看终端打印的实际 IP:8080，有线画面在 CanMV IDE 帧缓冲区；网页显示底部行及距离是否超范围，停车后可调阈值。到点触发及 AV OBS 诊断需更新 STM32 固件。步骤见 [AVOIDANCE_TEST.md](../AVOIDANCE_TEST.md)，不生成 ZIP。

物料夹取（target=0）只识别画面上方3/4：320×240下有效区域为y=0～179，下方60行不参与色块检测。请求ROI与该区域取交集；锚点仍为(160,120)，不改变返回坐标或视觉比例。圆环识别及暂存区物料定位（target=2）保持原请求ROI。更新MaixCAM2上的 `vision_detectors.py` 后重启相机程序即可生效，无需烧录主控。

## K230 二维码串口

K230 程序、辅助模块、测试及说明统一放在 `K230/`，直接上传源文件，不打包 ZIP。在 K230 CanMV 上单独运行 `K230/扫码.py`，与本目录的 MaixCAM `main.py` 分别用于扫码和物料/圆环对准。K230 IO9 配为 UART1_TXD，接 STM32 PB11/USART3_RX；K230 IO10 配为 UART1_RXD，接 STM32 PB10/USART3_TX；两板共地，并核对实际板卡的 IO 电平。串口为 115200、8N1。

### K230 黑色物块停车测试

只需要无线画面和阈值调试时，先将 `K230/wifi_config.example.py` 复制为本地 `wifi_config.py` 并填写Wi-Fi信息，再上传 `K230/避障无线预览.py`、`K230/obstacle_detection.py`、`K230/obstacle_web.py` 和 `K230/wifi_config.py`，详见 `K230/K230无线预览说明.md`。账号密码不提交到仓库。通过USB上传并启动后，电脑浏览器打开终端打印的URL；这个独立预览不启用UART、不控制车辆。

先将 `K230/避障停车.py` 和 `K230/obstacle_detection.py` 一起上传 K230，单独运行 `避障停车.py`，不要同时运行扫码脚本。默认 `UART_STOP_ENABLED=False`，不初始化串口、不通知STM32，可只给K230供电并通过USB CanMV IDE查看检测框与像素位置；确认后显示 `CONFIRMED`，不代表车辆停车。不属于 MaixCAM 安装包。有线预览使用 `img.compress_for_ide(quality=70)`，每帧完成检测框和红线绘制后直接发送给IDE，不初始化Display虚拟屏幕。

联调停车时将 `UART_STOP_ENABLED=True`，重新编译并烧录STM32固件，串口接线沿用上面的 UART1 → USART3。无线调试前可先通过USB运行 `k230_debug_info.py`，记录SYSTEM、PYTHON和MODULE输出，并记录电脑端IDE版本；该脚本不会初始化摄像头、串口或连接Wi-Fi。`Display.VIRT`本身不是无线图传，需要另行确认固件支持的网络调试/图传方式。

本阶段仅做像素定位和可选停车，没有毫米坐标、测距或路径重规划。默认ROI为640×480画面的下方2/3，即(0,160,640,320)，上方1/3不参与识别，坐标仍以完整画面为基准，LAB阈值沿用bizhang.py，有线预览最低黑色像素数默认2200（无线默认5000，可在网页调整），find_blobs的像素和包围框面积预筛选均使用同一门槛；从有效色块中选择像素数最大的一个，不设面积上限。首次检出位置作为稳定窗口锚点，中心各轴偏差不超过40像素，连续3帧确认；漏检或中心超限会重新确认。启用串口时确认后发送精确ASCII行 `OB:STOP\n`，每200ms重复发送，界面 `STOP TX` 只代表发送状态，不代表STM32已经确认停车；独立预览只输出检测日志。显示中心u/v、包围框底部行和黑色像素数，底部行只是预览估计，不能当作标定后的地面接触点。

STM32在USART3中断内识别完整停车行，立即设置现有急停请求；由主循环执行停车、取消动作/路线、清除排队的上位机指令并解除授权，输出 `OBSTACLE STOP; black blob detected; disarmed`。不会自动继续；移走物块后仍需重新授权并发起动作。QR行和含有OB:STOP文字的二维码不会触发障碍停车。该消息没有确认回包或校验和。

验证顺序：先架空核对电机方向、急停和接线，用黑物块观察CANDIDATE→STOP TX以及主控停车日志；移走后确认不自行恢复；再用实物地面、灯光与阴影调整BLACK_THRESHOLD、ROI和MIN_PIXELS，最后低速短程测试停车距离。摄像头断开、程序退出或未识别时不会主动停车，这不是通信失联保护。检测区域内任意合格黑块都可能触发，面积最大也不代表最近；固定前向摄像头不覆盖侧向和后方运动。未经实测不能用于自主比赛。

离线检查：`python -m unittest discover -s test/mecanum_jog/camera_code/K230 -p 'test_*.py'` 和 `powershell -File test/mecanum_jog/tests/test_obstacle_runtime.ps1`；C解析测试为 `tests/test_obstacle_stop.c`。

K230 发现二维码后发送 `QR:<UTF-8内容>\n`，内容最长 48 字节，换行和控制字符替换为空格；首次识别到可发送内容后仅发送一次，按115200/8N1留出本行发送时间后退出识别循环，不等待主控确认。随后依次停止sensor、关闭Display、等待100ms释放媒体缓冲，再释放MediaManager和UART；这是软件停止采图及显示，K230整板仍供电。下次扫码需重新运行脚本或重新上电。STM32 验证行格式后在蓝牙串口输出 `QR RESULT value=<内容>`，上位机“场地定位”页显示结果。二维码使用完整四组 `CCC+PPP+CCC+PPP`（例如 `156+123+516+231`）。完整任务在二维码点至少停车1秒，并采用本次已缓存的首个合法四组扫码结果（可在按键启动前或行驶途中收到）；未收到时继续等待，以该码决定两轮颜色顺序和放置位置；非法内容继续等待，不使用上位机预先下发的任务码作为后备。PC9可在上电后独立启动，不要求连接上位机。

将本目录全部文件部署到MaixCAM，运行 `main.py`。默认使用MaixCAM2 UART4：A21/TX、A22/RX、9600 baud；分别交叉连接STM32 PC11/UART4_RX、PC10/UART4_TX，并共地。若实际板型引脚不同，只修改 `vision_settings.py` 的设备和引脚映射。

正式程序在圆环模式使用640×480，物料模式使用320×240，收到模式切换请求时调整摄像头分辨率。圆环先进行3×3高斯滤波及非锐化掩模，再使用21×21邻域的自适应反向二值化。协议中的ROI、锚点、返回圆心和直径仍以320×240为坐标基准：圆环检测时放大ROI，检测后换算回原坐标；画面标记同步放大。现有STM32标定参数无需因坐标单位变化而修改，但切换分辨率后的视野与识别耗时须实机确认。

普通圆环检测仅接受 `target=2`。先检测同心圆环，再由 `ring_digits.py` 识别中心白色区域的1/2/3，只保留数字2对应的圆环，返回圆环中心。第二轮码垛的例外见下文v1.0.10：跳过数字识别，优先对齐圆环。没有2、存在多个2或字形匹配不明确时返回无效结果；不按左右顺序推断编号。模板包含用户提供实物照片的字形及OpenCV字体，支持旋转方向和倾斜。`RING_DIGIT_ROI_RATIO`、最低匹配分数及分数差在 `vision_settings.py` 中设置；分数是模板匹配指标，不是识别正确率。已用实物照片及合成图离线检查，摄像头视角、透视、遮挡和设备耗时尚需实机验证。

重新打包相机应用时必须包含 `ring_digits.py`，加上原有 `main.py`、`vision_detectors.py`、`vision_protocol.py`、`vision_settings.py` 共五个文件；`app.yaml` 已更新。比赛流程继续请求2号环；物料规则变更须配套更新STM32。手动请求1/3号环将得不到有效结果。

正式程序将B25配置为GPIO并保持低电平，板载补光灯在物料及圆环模式均关闭；正常退出或识别循环运行异常时再次输出低电平。普通数字圆环模式将相机对比度设为80，返回结果后及连续相同圆环请求之间保持；第二轮无数字圆环模式使用进入圆环前读取的物料对比度，以保持颜色辅助选环的原图像条件，切回物料备用时也恢复该值。两种圆环模式之间直接切换时更新对比度，不重复切换640×480分辨率，不写死物料对比度。MaixCAM2的物理引脚名为 `B25`，GPIO功能名和GPIO构造参数均为 `GPIOB25`，已与[官方引脚映射源码](https://github.com/sipeed/MaixCDK/blob/main/components/peripheral/port/maixcam2/maix_pinmap.cpp)核对；[GPIO说明](https://wiki.sipeed.com/maixpy/doc/en/peripheral/gpio.html)中的MaixCAM2示例名称与该源码不一致，不能照抄。对比度读取与恢复使用[官方相机接口](https://wiki.sipeed.com/maixpy/api/maix/camera.html)中的 `constrast()`。

程序只响应STM32请求，不主动发送运动命令。每个请求先丢弃2帧。取料物料（mode=1、target=0）要求连续10个有效帧，整个窗口横纵中心波动分别不超过8px，同时前5帧与后5帧的中心中位数在横纵两轴分别相差不超过2px；不再要求持续500ms，返回这10帧中心的中位数。颜色切换、目标丢失、采图为空、波动超限或前后中位数偏移超限后重新计数，每次新请求独立确认。圆环要求至少3帧、180ms、2px；第二轮码垛优先请求圆环，检测失败后的中间指定颜色物料备用（mode=1、target=2）保持至少5帧、500ms、2px并返回当前中心。物料请求1200ms、圆环请求1000ms内未稳定则返回无效结果，主控通信超时仍为1800ms。

正式相机和STM32均取消物料质量门槛。q字段保留原来的像素占比计算，仅用于诊断；圆环仍要求q≥60。物料有效标志只依据成功检测与静止判断，主控仍检查实际颜色、稳定标志和token。

正式物料检测采用用户提供的《物料.py》六组LAB阈值，见 `vision_settings.py`。每种允许颜色先取 `blob.area()` 最大的色块，再检查1500～30000的面积范围，以 `cx()/cy()` 为本帧中心；保留find_blobs的area_threshold=50、pixels_threshold=50及主控请求ROI。删除ROI贴边和锚点距离筛选。不限颜色时从各颜色合格结果中选面积最大的，面积相同时按颜色编号顺序选择，不再因多个颜色同时出现而拒绝。颜色编号仍为1红、2黄、3蓝、4绿、5黑、6浅蓝。

标定步骤：

1. 架空验证车体前后、左右方向，确认急停有效。
2. 分别对物料和三个物理圆环设置不会互相重叠的ROI与目标锚点。
3. 在中心、上下左右和四角至少九个位置记录像素误差及车辆实际毫米偏差。
4. 拟合 `forward_mm=a*du+b*dv`、`right_mm=c*du+d*dv`。
5. 将ROI、锚点和矩阵写入上级目录 `vision_config.h`，最后才把对应 `calibrated` 置1。
6. 先用5mm人工点动验证符号，再从小偏差开始自动闭环测试。

固定30字节帧定义见 `vision_protocol.py`。CRC为CRC-16/CCITT-FALSE，测试向量 `123456789 → 0x29B1`。

## 黑色圆环中心抖动测试

直接在 MaixVision 中打开并运行 `ring_jitter_test.py` 即可。脚本内置当前车辆的
圆环检测与稳定判定，不依赖其他项目文件；也可上传到 MaixCAM2 单独运行。
不要同时运行车辆视觉 `main.py`；测试程序不打开串口，不发送运动指令。

1. 固定相机和圆环，修改脚本顶部 `ROI`，使区域只包含一个完整圆环靶标，
   `ANCHOR` 放在该区域内。复现车辆问题时使用车辆实际请求的 ROI。
2. 自动按0%、20%、40%、60%占空比测试补光，使用B25/PWM6，PWM6不能同时用于A30。
   每档等待2秒再采集10秒，各档重新清空窗口；完成约需48秒，正常退出时关闭灯。
3. 全程固定相机、圆环和环境光。红色十字为原始中心，黄色十字为最近500ms
   有效连续检测的中心中位数，绿色圆为通过筛选的轮廓。
4. 屏幕 `old_stable` 使用现有2px、至少5帧、至少180ms的原始稳定条件。
   `span` 是最近500ms窗口各轴最大值减最小值；窗口丢失目标后清空。
   窗口未满500ms时也显示统计值，不能仅凭这个值确认稳定。
5. 每档结束输出 `RESULT light=...`，包含帧数、有效率、满足原始稳定条件的帧数
   及占比、中位数、各轴波动范围和总体标准差。先比较有效率和稳定帧占比，
   再比较波动；完全无有效目标时会明确提示。当前目录生成 `ring_jitter.csv`，
   每次运行覆盖，需先保存旧文件。
   CSV逐帧记录亮度档位、档内采样时间、坐标、有效状态、轮廓数、候选靶标数、轮廓半径和中心、原始稳定
   判定及500ms窗口统计。无有效中心时坐标和统计字段留空。

静止时若坐标突跳与轮廓数量/半径变化同步，重点检查轮廓切换；若长期只有
小幅随机抖动但 `old_stable` 很少成立，再根据实测噪声及允许的定位误差调整
圆环专用容差。多个候选靶标导致 `valid=0` 属于识别歧义，不代表物料移动。
每档总体统计只统计有效中心，需结合有效率判断，不能把丢失检测当成稳定。

## 历史物料检测预览（未同步v1.0.9）

这些独立脚本保留旧阈值、质量筛选和稳定规则，不能代表v1.0.9正式检测；验证新规则请运行main.py并接入主控请求。停止正式应用后，在MaixVision中直接运行 `material_preview.py`。此脚本内置当前正式检测逻辑、稳定判定和六色阈值，不依赖旁边的Python文件，不打开串口，不发送动作。后续修改正式阈值时需同步修改本脚本的 `COLOR_THRESHOLDS`。默认持续检测全部六色，画面标出颜色、圆形识别框、当前中心、质量和稳定状态；底部保留最近一轮结果。

脚本模拟物料请求：每轮丢弃2帧，1200ms超时，随后自动开始下一轮。测试稳定判定已改为容忍短暂漏检：只统计有效中心，保留最近500ms窗口及边界前一个有效样本，至少5个有效样本且首尾跨度≥500ms；横纵坐标范围都须满足容差。无效帧不能确认稳定，连续丢失超过 `MAX_MISSING_MS=200`、颜色切换或坐标超限时重新计时。`TARGET=0` 使用8px容差和中心中位数；1～3使用2px容差。`valid` 表示中心稳定，`usable=1` 还要求达到该颜色的最低q：黑30、红/黄/蓝/绿/浅蓝60，可在 `MIN_QUALITY` 中调整。画面与终端显示当前q和门槛min。分颜色质量门槛已同步到正式相机程序及STM32；漏检容忍仍仅在预览脚本中。通过顶部 `COLOR`、`COLOR_MASK`、`ROI`、`ANCHOR` 设置与STM32请求相同的条件；默认ROI是全画面。此预览不验证UART通信或整车动作。

## 历史六色物料诊断（未同步v1.0.9）

在MaixVision中单独运行 `material_jitter_test.py`，无需其他项目文件。
补光始终关闭，默认 `COLOR=0` 同时检测六种颜色；可改为1红、2黄、3蓝、4绿、5黑、6浅蓝以单独测试。脚本保留历史阈值，未同步本次正式应用修改。
设置与正式请求相同的 `ROI` 和 `ANCHOR`，只包含一个完整物料；白色采样框
必须完全位于物料表面，避开背景和高光，否则LAB统计没有参考意义。
启动预热2秒后持续识别，每10秒输出统计并清空本轮采样记录。可逐个更换物料，通过MaixVision停止按钮退出；不打开串口，不发送动作。

检测条件与正式物料算法一致。绿色框为候选色块，红色框为被过滤色块，
黄色十字为唯一候选中心，框旁标注颜色名称。全颜色模式下，多个物料或同一物料被多组阈值命中均判为歧义；颜色切换重新计时。输出有效率、稳定帧数、同时稳定且质量≥60的
可用帧比例、中心波动、质量值和采样框LAB均值的中位数。
`none`/`ambiguous` 为无候选／多候选帧数；`low_quality` 为唯一候选质量<60
的帧数；`area`/`clipped`/`outside` 为面积／ROI截断／锚点距离过滤的色块数。
诊断脚本的 `stable` 保留原2px、500ms条件；正式取料已放宽至8px，诊断结果不能直接等同于正式取料的稳定判定，仍须结合有效率和质量判断。
脚本只用于诊断，不会自动修改正式阈值；中心统计仅包含有效检测帧。

## 最大物料校准与指定颜色取料（v1.0.9）

主控物料请求selector=0表示不限颜色；`values[6]` 为允许颜色位掩码，颜色N对应位N-1，0表示检测全部支持颜色。两轮路线每批首次对准发送selector=0、掩码47（0x2F），只在红、黄、蓝、绿、浅蓝中选择最大面积物料，黑色不参与这一步；对准完成后请求切换为当前任务指定颜色和对应单色掩码。selector=1～6仅检测指定颜色。同色多个色块仍只取最大的。

帧仍为30字节、协议版本1，CRC与token不变。物料结果 `values[0:5]` 为中心U/V、诊断质量、宽、高；`values[5]` 为实际颜色1～6，0表示未知；其余结果字段为0。主控要求实际颜色属于允许范围，并在selector非0时与指定颜色一致；未知颜色、错误颜色和旧token不能触发运动或夹取。圆环结果保持原字段。

每批到取料区后，先用最大面积的非黑色物料校准，不必等待该批首件颜色。首次任意颜色与后续指定颜色阶段统一要求横纵各±14像素，含边界；一轮静止结果进入范围即可完成当前对准。首次任意颜色结果只能切换至任务指定颜色请求，不能直接夹取，必须重新采集连续10帧。任一轴偏差超限时按现有物料标定矩阵完整修正，运动结束后停稳300ms，再以新token请求复检；复检超限就再次修正，最多12次。观察水平位置仍为-770，其他机构姿态不变。相机识别与升降下降50mm并行；机构未准备完成不得夹取，完成后仍须获取新的合格结果。完整任务按两组任务颜色顺序依次放平台1/2/3槽；`route rawpick` 仍按绿/黄/浅蓝取料。圆环及暂存对准的毫米容差、两轮确认规则不变，单件静态夹取命令不新增底盘联动。

本次须同步更新STM32固件和相机应用。MaixVision安装 `dist/maix-gongchuang_vision-v1.0.11.zip`；也可上传app.yaml列出的全部文件并运行main.py。不要混用旧STM32质量门槛或旧相机阈值。新焦距下须重新核对物料的方向、毫米/像素比例及中心抓取点；本次未修改标定矩阵、未自动解锁标定。±14像素是联调范围，需实机验证抓取效果。

## 画面与耗时诊断

物料画面显示颜色、center中心、still静止状态、dx、dy及直线距离d（像素）。原点为屏幕中心(160,120)，dx向右为正、dy向上为正；主控仍使用图像纵轴向下的dv，不改变移动矩阵符号。夹取按两轴分别判断，并非按d判断，例如dx=20、dy=20仍在范围内。

fps为本轮物料检测帧完成时间之间的实际处理帧率，不是UART回包频率，也不是相机标称帧率；未检测或只有一帧时显示0。elapsed为从本次请求接收到当前帧处理完成的毫秒数，包含丢弃帧及采图/检测时间。每次返回结果打印 `VISION MATERIAL` 日志，空闲时保留最近结果文字。原料取料10帧规则不保证固定毫秒耗时，移动中的慢速物料仍需通过实机观察核对。

## v1.0.9离线验证

- `python -m unittest discover -s test/mecanum_jog/camera_code -p 'test_*.py'`：40项通过，包含物料边界、实际稳定窗口、漏检/颜色切换、新请求重置、串口参数、偏差/FPS显示及圆环回归。
- 现有Qt/MinGW环境构建成功；完整CTest为31/34通过，任务码、主控视觉及实际取料函数运行测试通过，覆盖两轮任务顺序、错误颜色、旧token、机构运动中禁止夹取和移动后复检。
- 未通过的3项为本次未修改的上位机测试：`test_mechanism_action_model`（legacy defaults）、`test_mechanism_action_page`（immediate servo step）、`test_route_editor`（mech pose指令预期）。完整日志位于 `upper_computer/build/material_109_ctest.log`。
- Keil ARMCC5编译当前MecanumJog工程：0错误、0警告。日志为 `test/mecanum_jog/build_material_109.log`，固件输出为 `test/mecanum_jog/Objects/MecanumJog.hex`；未自动烧录。
- 安装包包含app.yaml及五个正式Python文件，已校验版本、包内文件与源码一致、Python语法和ZIP CRC。六色阈值逐项与附件核对；圆环算法、参数和ring_digits.py与改动前一致。

以上路径以工作区根目录为基准。未连接MaixCAM2或车辆，实际帧率、照明下的识别、焦距改变后的移动比例及抓取效果尚未验证；标定锁定保持不变。先核对方向、机械限位与急停，再分段低速验证。

## 第二轮码垛圆环优先（v1.0.10）

第二轮码垛（TEMP_2）先发送mode=2、target=2、flags=0x04的请求。selector为第一层中间2号位置上的指定物料颜色，由第一轮任务码确定。0x04仅用于请求，表示跳过数字识别，不改变30字节帧、CRC或返回标志。普通粗加工、第一轮暂存及手动圆环请求仍识别数字2。

圆环阶段保持640×480、自适应二值化、同心轮廓筛选、补光10%、至少5帧/180ms/2px及1000ms时限。只有一个圆环候选时直接返回圆心；有多个圆环时，在同一640×480图像中只检测selector指定颜色，选择距该物料中心最近的圆环。该帧物料ROI、面积上下限按分辨率放大，中心及尺寸换算回320×240协议坐标，原料取料320×240下的阈值和面积范围不变。多个圆环却找不到指定颜色时不猜编号或位置。

首个匹配当前token的无效/不稳定圆环结果触发物料备用：主控下一次以新token发送mode=1、target=2和单色掩码，相机切至320×240、关闭补光，只返回中间指定颜色物料中心。切换后保持物料识别直到完成本次对齐，不来回切模式。旧圆环结果不得用于备用对齐，修正次数及累计位移保留；真正通信无回包仍按1800ms、三次超时停止，不作为检测失败切换。

两个分支均沿用圆环2的ROI、锚点及标定矩阵，以横纵各±2px范围（320×240协议坐标）和两轮独立确认完成对齐，移动结束停稳300ms后复检，最多12次修正。焦距及物料高度产生的比例差异仍需实机核对，本次未修改标定或解锁。

K230扫码程序同时更新为单次发送后停止，直接部署 `K230/扫码.py` 和 `K230/qr_protocol.py`，不属于MaixCAM应用安装包。

离线验证：相机及扫码Python测试47项通过；完整CTest为31/34通过，三个失败仍为未修改的机构动作模型、机构动作页面和路线编辑器测试，日志见upper_computer/build/stack_ring_110_ctest.log。实际主控服务函数测试覆盖圆环失败切换、指定颜色、旧结果拒绝和两轮确认；路线测试覆盖第二轮首先请求圆环、其他阶段保留数字模式。Keil编译0错误、0警告，日志见test/mecanum_jog/build_stack_ring_110.log。未烧录、未进行硬件验证。

关闭采图及显示接口依据CanMV官方文档：
- https://www.kendryte.com/k230_canmv/en/v1.3/api/mpp/K230_CanMV_Display_Module_API_Manual.html
- https://www.kendryte.com/k230_canmv/en/main/api/machine/k230_canmv_uart_api_manual.html

## 原料取料静止窗口（v1.0.11）

原料取料（mode=1、target=0）改为连续10个有效帧，仍要求整个窗口内横纵中心波动分别不超过8像素，无最低观察时间；返回10帧中心的中位数。目标丢失、颜色变化、采图为空或波动超限后重新计数。首次任意颜色校准和后续指定颜色夹取均采用此规则。

按实测25fps，10帧首尾跨度约360ms；每次请求仍先丢弃2帧，实际响应还包含丢弃帧、采图和通信时间。圆环保持至少5帧/180ms/2px，码垛物料备用保持至少5帧/500ms/2px。±14像素夹取范围及颜色、面积、串口协议参数均未在本次修改。

本次只需更新相机应用，不需要因帧数变化重新烧录STM32。全量Python测试47/48通过，10帧窗口、9帧不得确认、丢失/颜色切换/新请求重置、圆环及码垛回归通过；唯一失败是test_material_uses_attachment_thresholds，当前黑色L阈值8～25与测试旧值20～35不一致。本次保留当前阈值，未改动该测试断言。尚未实机验证。

## 首次取料校准排除黑色

仅首次任意颜色校准使用颜色掩码0x2F（47），排除黑色位；之后按任务请求指定颜色及单色掩码。指定黑色任务仍识别、移动校准和夹取，码垛及圆环流程不变。不增加顶部四分之一区域限制。

相机源码及协议均未修改，继续使用现有相机程序，只需更新主控固件。实际取料函数测试验证首次黑色结果不能触发移动，任务指定黑色仍可移动校准及夹取。Keil编译0错误、0警告；完整CTest为31/34通过，剩余3项为已有上位机机构动作模型、机构动作页面和路线编辑器失败，日志见upper_computer/build/no_black_first_alignment_ctest.log。未烧录或实机验证。

## 取料物料运动趋势判断（v1.0.12）

取料物料（mode=1、target=0）保留连续10帧、横纵总波动各不超过8px，在满10帧后分别计算前5帧和后5帧的中心中位数。任一轴中位数相差超过2px则判为仍在运动，以当前帧作为新窗口的第1帧，重新收集10帧；相差恰好2px允许通过。两轴都满足原有波动条件和新增趋势条件才返回静止标志及10帧中心中位数。首次任意颜色校准和指定颜色取料均使用此规则。

安装 `dist/maix-gongchuang_vision-v1.0.12.zip`，本次只需更新MaixCAM2应用。圆环与码垛物料备用的稳定规则、物料颜色/面积/长宽比/ROI、补光、串口协议及主控均保持当前实现。

离线测试覆盖两个轴的正负向漂移、2px边界、8px范围内的缓慢漂移、孤立抖动、运动停止后重新确认、目标丢失及颜色切换。前后中位数相差不超过2px的极慢移动仍可能通过，需要用实际物料速度及相机帧率验证；本次未实机验证。

全量Python测试56/57通过，唯一失败仍是黑色LAB阈值的旧测试预期（20～35）与当前配置（8～25）不一致；未更改阈值。完整CTest为31/34通过，三个已有上位机失败仍是机构动作模型、机构动作页面和路线编辑器，日志见 `upper_computer/build/material_motion_trend_ctest.log`。安装包已核对版本、文件内容、Python语法及ZIP CRC。

## 正式圆环识别参考附件调整（2026-10-13，源码更新）

本次仅调整正式程序，独立圆环调试脚本及既有安装包保留原内容。圆环检测参数集中在 `vision_settings.py`：640×480下锐化强度1.0、sigma=3.0，二值化邻域21、偏移10；轮廓半径50～160像素、面积至少π×50²×0.5、圆度至少0.5。取消轮廓父子层级过滤，使用图像矩计算圆心。

横纵圆心差分别小于8像素的轮廓归为同心组，至少两个轮廓即可，不再要求不同半径。按轮廓数量保留最多三个候选，再按平均横坐标排序；返回平均圆心及最大半径对应的直径。半径、聚类距离在配置中使用320×240协议单位，分别为25～80和4；320×240输入下二值化邻域11、sigma=1.5。数字识别仍使用未经锐化的原灰度图，普通模式仍只选数字2，码垛无数字模式仍沿用指定颜色物料辅助选环。

补光统一关闭、圆环对比度80及物料对比度恢复以本节和上方当前说明为准；前文各版本的补光记录属于历史行为。部署时同步更新 `main.py`、`vision_detectors.py`、`vision_settings.py`，保留同目录的 `ring_digits.py`、`vision_protocol.py`。本次不生成安装包、不修改STM32、物料阈值、标定、串口帧、稳定判定或超时。

离线验证：`python -m unittest discover -s test/mecanum_jog/camera_code -p 'test_*.py'` 共60项通过，覆盖筛选边界、同心聚类、两种分辨率、偏移ROI、数字2及码垛回归、对比度恢复、补光关闭和异常退出。尚未部署或实机验证；需要确认无补光下的识别率及圆心抖动、圆环请求是否在1000ms内完成，以及切回物料后原阈值的识别效果。

### 圆环持续WAIT的诊断日志

主控在粗加工圆环阶段持续WAIT、相机连续输出 `VISION RESULT valid=False` 时，表示未通过有效及稳定确认；结果中的quality=80和最后一帧圆心坐标不能代替稳定标志。主控未通过确认时不会重新计算forward_mm/right_mm，日志可能保留上次微调值。

正式 `main.py` 现在每次圆环回包后输出 `VISION RING`：`frames` 为本请求实际执行的检测次数（不含丢弃的2帧），`hits` 为成功检测次数，`window` 为当前连续稳定窗口帧数，`window_ms` 为该窗口在现有判定时间戳下的跨度，`span` 为窗口内两轴总波动（320×240协议像素），`elapsed_ms` 为回包后的请求总耗时，`detect_ms` 为累计圆环算法耗时。计数在每个新请求重置。

失败时frames不足3，应检查采图、显示、数字识别等耗时；frames足够但hits较少，说明存在漏检；hits足够但window不足3，说明稳定窗口曾被漏检或圆心波动清空。单看最后一帧坐标重复，无法证明此前连续3帧稳定。当前圆环确认采用3帧/180ms/2px；诊断日志不改变这些条件、1000ms超时或主控两轮确认规则。

本次只需覆盖设备 `/maixapp/apps/gongchuang_vision/main.py`，重新运行后在设备终端执行 `tail -n 100 /maixapp/tmp/last_run.log` 获取新日志。现有ZIP未重新打包。

### 圆环确认帧数改为4帧（2026-10-13）

设备实测连续请求均得到frames=4、hits=4、window=4，圆心波动0～1像素，请求总耗时约1.5～1.67秒，累计算法耗时约1.2～1.4秒；原5帧要求导致这些结果持续无效。按用户选择，仅将普通圆环及码垛无数字圆环的确认帧数从5改为4，保留180ms、2px、原超时检查、主控±2px对准及两轮独立确认。物料取料仍为10帧，码垛物料备用仍为5帧，不修改共享StableWindow默认值、独立调试脚本或STM32。

离线验证：相机目录63项测试通过，覆盖3帧不得确认、4帧确认、179/180ms边界、漏检及波动超限重置、超时检查所在循环完成第4帧确认，以及数字圆环、码垛与物料回归。只需更新相机main.py；未重新打包ZIP，未进行更新后的实机验证。

### 第二轮颜色辅助选环的对比度修正（2026-10-14）

第二轮无数字圆环请求（flags=0x04）在检测多个圆环时复用物料色阈值辅助选环；原先统一设置对比度80，改变了这些阈值对应的图像条件。本次让该模式在640×480下使用进入圆环前保存的物料对比度。普通数字圆环仍用80；普通圆环、无数字圆环、物料之间切换时分别应用对应对比度，同类连续请求保持设置。模式切换后仍丢弃2帧并重置稳定窗口。

本次不修改颜色阈值、圆环算法、ROI及坐标换算、4帧/180ms/2px、码垛物料备用5帧/500ms/2px、通信协议或主控动作条件。相机目录65项测试通过，包含码垛请求首次采图前恢复原对比度、双向圆环模式切换、连续请求以及失败后物料备用回归。仅需覆盖设备main.py并重启；现有ZIP未更新，仍需实机验证第一层中间指定颜色物料的识别和选环结果。

### 避免多轮切换累积改变物料对比度（2026-10-14）

确认第二轮已经进入mode=MATERIAL备用后，进一步核对相机设置。此前每次从物料进入圆环都会重新读取对比度；[官方MaixCAM2实现](https://github.com/sipeed/MaixCDK/blob/main/components/vision/port/maixcam2/maix_camera_maixcam2.cpp)的constrast()读取使用整数返回值，且读写比例分别为8196和8192，读到的数值写回后可能不完全相同。重复读取并覆盖物料基准可能产生累积偏移，备份程序没有这些写入。设备所用SDK是否与该源码一致、该风险是否导致现场漏检，仍需实机确认。

正式main.py现在仅在首次进入圆环前保存一次物料对比度，后续第二轮无数字圆环及物料备用始终使用这份缓存，避免把恢复后重新读取的量化值作为新基准。它避免的是累积偏移，并不保证百分比接口能精确保存底层ISP原始值。模式切换日志 `VISION CAMERA` 输出mode、no_digit、contrast_set和contrast_readback；回读值来自设置接口的返回值，允许包含SDK量化差异，不将回读值覆盖基准。

相机目录66项测试通过，包括模拟每次回读损失1的SDK行为，验证多次圆环/物料切换及第二轮物料备用仍使用首次基准。物料识别和稳定规则与校赛备份一致，主控未修改。更新设备main.py并重启后生效；本次未重新打包ZIP，现场码垛识别结果尚未验证。

### 圆环确认改为3帧、默认比例更新（2026-10-14）

按用户选择，普通数字圆环及码垛无数字圆环稳定窗口从4帧改为3帧，至少180ms、两轴波动各不超过2px、丢弃2帧和现有超时检查保持不变。两帧不能确认，漏检及波动超限仍重置窗口；物料取料10帧和码垛物料备用5帧/500ms均不变。按此前每帧约300～350ms的实测，可减少一帧确认等待，更新后的实际耗时仍需设备验证。

圆环2默认比例按用户截图设为前后1.111、左右1.143 mm/协议像素，统一定义在 `../vision_defaults.h`，主控上电默认及上位机视觉、路线编辑输入共用；物料仍为0.640/0.673。主控最终对准各轴±2px和两轮确认保持不变。新默认比例需更新主控固件和上位机，3帧规则需覆盖相机main.py并重启；本次未重新打包相机ZIP，未烧录或实机验证。
