threebod/mecanum_jog/snapshots/pre-material-layout-20261015/README.md

# 三物料方案修改前的外部源码快照

保存日期：2026-10-15。文件保持相对于 gongchuang 工作区的原路径，manifest.json 记录 SHA-256。

当前固件与相机源码由 mecanum_jog 的 pre-material-layout-20261015 标签保存，上位机由 robot-tuner 的同名标签保存。恢复外部依赖时，将本目录的 yyb_stm32、动作组、路线组放回工作区根目录的对应位置。

不包含构建产物、Keil 本机配置或 Wi-Fi 凭据。本快照保存既有参数，不代表本次已进行硬件验证。
