threebod/mecanum_jog/snapshots/pre-material-layout-20261015/路线组/当前路线说明.md

# 当前两轮路线 JSON

这两个文件可在上位机“路线编辑”页通过“打开 JSON”加载。它们是人工识别衔接版，不是原固件完整自动流程的等价实现。

## 使用前提与差异

- 从对应启停区出发，车头朝地图上方；初始机构水平0、升降0、云台65°，夹爪张开70°，平台1槽26°。在动作录入页完成实际位置确认及初始化后，再开始路线。
- 固件原入口也允许云台270°和夹爪35°；本导出采用当前上位机任务入口的65°、70°准备状态，不兼容这些替代起始姿态。
- 使用编译默认底盘200 RPM、横移上限150 RPM、前后比例1.0、横移比例0.9，以及视觉比例640/673。未读取设备RAM或当前GUI调参值，运行前核对实际设置。
- 不限颜色对准、每件指定颜色确认，以及第二轮暂存按圆环2标定识别绿色物料，均用人工确认替代；这些确认步骤不会自动识别或调整车辆。人工调整仅平移，须保持本段车头方向。
- 人工确认期间其他运动页面被路线执行器锁定。不要尝试启动另一条路线或原料区联调；需要软件控制调整时，先停止当前路线，单独完成准备后从合适步骤重新测试。
- 动作序列和参数取自当前固件实际C数组，未采用可能过期的“动作组”目录JSON。每个内嵌动作组的initialState按该处实际入口姿态、夹爪和平台槽衔接填写。
- 固件中平台零等待转动可与机构动作并行；路线编辑器按动作到位顺序执行，故顺序和落点保留，但节拍与固件并行流程不同。
- 转向终态保留。180°步骤固定选择JSON中的左／右方向；原固件按实际IMU角差选择，正负180°边界时旋转方向可能不同。
- 二维码点保留1秒等待，沿用现有K230接收和显示，不按扫码结果调整取料顺序。视觉对准后不回退微调距离。
- 航段方向已经由地图坐标换算成当前车头坐标。例如第一次到原料区是地图向左，但车头已朝左，JSON为W前进980 mm（启停区1）或930 mm（启停区2）。
- 路线抵达偏移站点后按新的停车位置衔接后续原定相对距离，没有额外回到旧名义坐标的运动。
- JSON加载和软件校验不代表实机距离、净空或取放结果已经验证；本次没有烧录或驱动车辆。

## 来源

两份JSON均已通过上位机实际 `loadRouteSequence` 加载器。各含62个路线步骤、275个机构动作；23个内嵌动作组的入口姿态、夹爪和平台状态均已逐组检查衔接，首次取料距离、第二次取料补偿及最终车头朝向也已检查。本次没有修改上位机或固件功能代码。

由以下当前本地文件导出：

- test/mecanum_jog/main.c；SHA-256：96c9009b18ac86af87bdbadf40af3161feff5798cd197c38d9f510d6f9ea3808
- test/mecanum_jog/route_plan.h；SHA-256：710bd8f4e1743939427f000f154e0501175db46baa57fb48e833c7d6d8e731a7
- test/mecanum_jog/raw_pick_action.h；SHA-256：58f6b59a7d48a8d51b439401e1fdfc52222c7db531de4f0ba9fac17eaf5380f5
- test/mecanum_jog/mission_actions.h；SHA-256：0c0357cdefd70446b8ac4dba69e264ade74ced8b45625b73f8ac8ef43e2ac662

## 启停区1：当前两轮取放_启停区1_人工确认版.json

共62步；类型数量：confirm=10，action=23，move=17，turn=8，wait=1，vision=3。

|步骤|位置／用途|参数|
|---:|---|---|
|1|起点与初始状态确认|人工确认后继续|
|2|出发前核对机构与舵机初始状态（不运动）|1个机构动作|
|3|航段1：转折点|A 150 mm，200 RPM|
|4|航段2：QR|S 1050 mm，200 RPM|
|5|航段2：QR到位后转向|R 90°|
|6|二维码停车等待1秒；不以扫码结果排序|1000 ms|
|7|航段3：转折点|A 830 mm，200 RPM|
|8|航段3：转折点到位后转向|L 180°|
|9|航段4：RAW_1|W 980 mm，200 RPM|
|10|第1轮取料：第1件拍照准备|1个机构动作|
|11|第1轮不限颜色对准（人工）|人工确认后继续|
|12|第1轮确认绿色（人工）|人工确认后继续|
|13|第1轮夹取绿色→平台1槽|13个机构动作|
|14|第1轮取料：第2件拍照准备|1个机构动作|
|15|第1轮确认黄色（人工）|人工确认后继续|
|16|第1轮夹取黄色→平台2槽|13个机构动作|
|17|第1轮取料：第3件拍照准备|1个机构动作|
|18|第1轮确认浅蓝色（人工）|人工确认后继续|
|19|第1轮夹取浅蓝色→平台3槽|13个机构动作|
|20|航段5：COARSE_1_DROP_PICK|A 1680 mm，200 RPM|
|21|航段5：COARSE_1_DROP_PICK到位后转向|R 180°|
|22|第1轮粗加工：圆环观察准备|1个机构动作|
|23|第1轮粗加工：圆环2对准|圆环2，640/673|
|24|第1轮粗加工：三件放置（第三件原位直接回收）|31个机构动作|
|25|第1轮粗加工：按3→1→2回收至原平台槽|29个机构动作|
|26|航段6：转折点|A 800 mm，200 RPM|
|27|航段7：TEMP_1_DROP|S 900 mm，200 RPM|
|28|航段7：TEMP_1_DROP到位后转向|R 90°|
|29|第1轮暂存：观察准备|1个机构动作|
|30|第一轮暂存：圆环2对准|圆环2，640/673|
|31|第1轮暂存：第一层放置|33个机构动作|
|32|航段8：转折点|A 800 mm，200 RPM|
|33|航段9：RAW_2先向地图上方980 mm|S 980 mm，200 RPM|
|34|航段9：RAW_2再向地图右侧50 mm|A 50 mm，200 RPM|
|35|航段9：RAW_2到位后转向|R 90°|
|36|第2轮取料：第1件拍照准备|1个机构动作|
|37|第2轮不限颜色对准（人工）|人工确认后继续|
|38|第2轮确认黑色（人工）|人工确认后继续|
|39|第2轮夹取黑色→平台1槽|13个机构动作|
|40|第2轮取料：第2件拍照准备|1个机构动作|
|41|第2轮确认红色（人工）|人工确认后继续|
|42|第2轮夹取红色→平台2槽|13个机构动作|
|43|第2轮取料：第3件拍照准备|1个机构动作|
|44|第2轮确认蓝色（人工）|人工确认后继续|
|45|第2轮夹取蓝色→平台3槽|13个机构动作|
|46|航段10：COARSE_2_DROP_PICK|A 1680 mm，200 RPM|
|47|航段10：COARSE_2_DROP_PICK到位后转向|R 180°|
|48|第2轮粗加工：圆环观察准备|1个机构动作|
|49|第2轮粗加工：圆环2对准|圆环2，640/673|
|50|第2轮粗加工：三件放置（第三件原位直接回收）|31个机构动作|
|51|第2轮粗加工：按3→1→2回收至原平台槽|29个机构动作|
|52|航段11：转折点|A 800 mm，200 RPM|
|53|航段12：TEMP_2_STACK|S 900 mm，200 RPM|
|54|航段12：TEMP_2_STACK到位后转向|R 90°|
|55|第2轮暂存：观察准备|1个机构动作|
|56|第二轮暂存：绿色物料按圆环标定对准（人工）|人工确认后继续|
|57|第2轮暂存：第二层堆叠（升降680/600/650）|33个机构动作|
|58|航段13：转折点|A 800 mm，200 RPM|
|59|航段14：转折点|A 900 mm，200 RPM|
|60|航段14：转折点到位后转向|R 180°|
|61|航段15：转折点|W 1050 mm，200 RPM|
|62|航段16：HOME|D 150 mm，200 RPM|

## 启停区2：当前两轮取放_启停区2_人工确认版.json

共62步；类型数量：confirm=10，action=23，move=17，turn=8，wait=1，vision=3。

|步骤|位置／用途|参数|
|---:|---|---|
|1|起点与初始状态确认|人工确认后继续|
|2|出发前核对机构与舵机初始状态（不运动）|1个机构动作|
|3|航段1：转折点|A 150 mm，200 RPM|
|4|航段2：QR|W 1050 mm，200 RPM|
|5|航段2：QR到位后转向|R 90°|
|6|二维码停车等待1秒；不以扫码结果排序|1000 ms|
|7|航段3：转折点|A 830 mm，200 RPM|
|8|航段3：转折点到位后转向|L 180°|
|9|航段4：RAW_1|W 930 mm，200 RPM|
|10|第1轮取料：第1件拍照准备|1个机构动作|
|11|第1轮不限颜色对准（人工）|人工确认后继续|
|12|第1轮确认绿色（人工）|人工确认后继续|
|13|第1轮夹取绿色→平台1槽|13个机构动作|
|14|第1轮取料：第2件拍照准备|1个机构动作|
|15|第1轮确认黄色（人工）|人工确认后继续|
|16|第1轮夹取黄色→平台2槽|13个机构动作|
|17|第1轮取料：第3件拍照准备|1个机构动作|
|18|第1轮确认浅蓝色（人工）|人工确认后继续|
|19|第1轮夹取浅蓝色→平台3槽|13个机构动作|
|20|航段5：COARSE_1_DROP_PICK|A 1680 mm，200 RPM|
|21|航段5：COARSE_1_DROP_PICK到位后转向|R 180°|
|22|第1轮粗加工：圆环观察准备|1个机构动作|
|23|第1轮粗加工：圆环2对准|圆环2，640/673|
|24|第1轮粗加工：三件放置（第三件原位直接回收）|31个机构动作|
|25|第1轮粗加工：按3→1→2回收至原平台槽|29个机构动作|
|26|航段6：转折点|A 800 mm，200 RPM|
|27|航段7：TEMP_1_DROP|S 900 mm，200 RPM|
|28|航段7：TEMP_1_DROP到位后转向|R 90°|
|29|第1轮暂存：观察准备|1个机构动作|
|30|第一轮暂存：圆环2对准|圆环2，640/673|
|31|第1轮暂存：第一层放置|33个机构动作|
|32|航段8：转折点|A 800 mm，200 RPM|
|33|航段9：RAW_2先向地图上方980 mm|S 980 mm，200 RPM|
|34|航段9：RAW_2再向地图右侧50 mm|A 50 mm，200 RPM|
|35|航段9：RAW_2到位后转向|R 90°|
|36|第2轮取料：第1件拍照准备|1个机构动作|
|37|第2轮不限颜色对准（人工）|人工确认后继续|
|38|第2轮确认黑色（人工）|人工确认后继续|
|39|第2轮夹取黑色→平台1槽|13个机构动作|
|40|第2轮取料：第2件拍照准备|1个机构动作|
|41|第2轮确认红色（人工）|人工确认后继续|
|42|第2轮夹取红色→平台2槽|13个机构动作|
|43|第2轮取料：第3件拍照准备|1个机构动作|
|44|第2轮确认蓝色（人工）|人工确认后继续|
|45|第2轮夹取蓝色→平台3槽|13个机构动作|
|46|航段10：COARSE_2_DROP_PICK|A 1680 mm，200 RPM|
|47|航段10：COARSE_2_DROP_PICK到位后转向|R 180°|
|48|第2轮粗加工：圆环观察准备|1个机构动作|
|49|第2轮粗加工：圆环2对准|圆环2，640/673|
|50|第2轮粗加工：三件放置（第三件原位直接回收）|31个机构动作|
|51|第2轮粗加工：按3→1→2回收至原平台槽|29个机构动作|
|52|航段11：转折点|A 800 mm，200 RPM|
|53|航段12：TEMP_2_STACK|S 900 mm，200 RPM|
|54|航段12：TEMP_2_STACK到位后转向|R 90°|
|55|第2轮暂存：观察准备|1个机构动作|
|56|第二轮暂存：绿色物料按圆环标定对准（人工）|人工确认后继续|
|57|第2轮暂存：第二层堆叠（升降680/600/650）|33个机构动作|
|58|航段13：转折点|A 800 mm，200 RPM|
|59|航段14：转折点|A 900 mm，200 RPM|
|60|航段14：转折点到位后转向|R 180°|
|61|航段15：转折点|S 1050 mm，200 RPM|
|62|航段16：HOME|D 150 mm，200 RPM|
