threebod/mecanum_jog/snapshots/pre-material-layout-20261015/动作组/当前固件执行_2026-10-08/导出说明.md

# 当前固件执行动作组（2026-10-08）

可在上位机“动作录入”页打开各JSON，也可作为动作组导入“路线编辑”页。

14份JSON、188个动作已通过当前上位机实际动作组加载器和参数校验，并核对272°观察角度、65°恢复动作及取放深度。导出前后源文件哈希一致。

按当前本地固件源码重新编译导出实际动作数组和动态生成的动作；未读取串口实时状态，也未确认实车烧录版本。原“动作组”目录文件与此前路线JSON未改动。

## 文件与入口状态

所有文件关闭循环。夹爪初始状态均为张开70°，闭合35°；平台槽1/2/3角度为26°/146°/264°。
入口水平／升降单位为0.1 mm，云台为0.1°；initialState按实际作业阶段的入口填写，而非一律使用固件模板的零位。

|文件|动作数|入口H/L/T|入口平台槽|用途|
|---|---:|---|---:|---|
|01_首次取料拍照准备_65转272.json|1|0/0/650|1|第一轮第一件；水平收至-500，云台转272°|
|02_取料拍照准备_平台2.json|1|0/0/2720|2|每轮第二件拍照准备|
|03_取料拍照准备_平台3.json|1|0/0/2720|3|每轮第三件拍照准备|
|04_夹取_第一轮平台1.json|13|-500/0/2720|1|第一轮第一件放入平台1槽|
|05_夹取_第二轮平台1.json|13|-500/0/2720|2|第二轮第一件；第一轮暂存结束后平台在2槽，动作中切至1槽|
|06_夹取_平台2.json|13|-500/0/2720|2|每轮第二件放入平台2槽|
|07_夹取_平台3.json|13|-500/0/2720|3|每轮第三件放入平台3槽|
|08_粗加工圆环观察准备.json|1|0/0/650|3|两轮粗加工对准前；升降准备速度90 RPM、加速度50|
|09_粗加工三件放置.json|31|-500/0/2720|3|三个落点升降均为1300；第三件松爪后保持原位|
|10_粗加工回收_3到1到2.json|33|50/1300/3080|3|第三件原位直接夹紧，再按3→1→2回收；深度均为1300|
|11_暂存观察准备.json|1|0/0/650|2|两轮暂存对准前；回收最后停在平台2槽|
|12_暂存第一层放置.json|33|-500/0/2720|2|三个落点升降均为1300|
|13_暂存第二层堆叠.json|33|-500/0/2720|2|三个落点升降为[650, 650, 650]，比第一层少下降65 mm|
|14_第二轮首次取料拍照准备_65转272.json|1|0/0/650|2|第二轮第一件；从65°进入观察姿态，平台保持2槽|

## 参数和执行差异

- 取放动作水平500 RPM、升降1000 RPM，两轴加速度200；云台、夹爪及平台速度字段为1800（180°/s）。圆环观察准备单独沿用源码中的升降90 RPM、加速度50。
- 固件对空载云台有200°/s覆盖规则；JSON保留动作表中180°/s字段，不额外修改运行时规则。
- 第一轮首次取料入口可能为夹爪35°；本导出按上位机任务准备后的张开70°填写。若实际入口不同，须核对并修改初始状态，不能用初始化声明替代实际到位。
- 每份动作组只包含机构动作，不包含颜色识别、圆环对准、底盘微调或路线移动；须在正确位置和观测／对准状态下使用。
- 粗加工回收从第三件刚放下的50/1300/3080姿态开始，第一件回收不额外张爪、抬升或下降；不得从零位直接测试该组。
- 固件的零等待平台转动可与机构动作并行；上位机逐步执行可能等待平台到位，动作顺序和参数一致，但节拍不完全相同。
- 第三件取料动作直接收回至0/0/650；粗加工回收先抬升、收回水平轴，再直接转65°。
- 物料首次对准和后续±30像素夹取判断由固件视觉状态机执行，JSON不包含这些判定。
- 本次只导出和校验文件，未修改固件／上位机代码，未烧录或驱动车辆。

## 来源校验

- test/mecanum_jog/main.c；SHA-256：e3baa72b02657a99c22cb8a0bf7e0ce89a97c02ca44f2ae9c0d55700583a11ae
- test/mecanum_jog/raw_pick_action.h；SHA-256：d02f139f6f4d96771177574edf47df446e0a5cffff9eda55f87d072ee566c9fd
- test/mecanum_jog/mission_actions.h；SHA-256：6657c4b96b4fe543f675fd26ace4baf2893f13dc5ef5fc8f9eed5b125270e916
