threebod/mecanum_jog/ROUTE_TEST.md

# 地图底盘路线测试（蓝牙启动）

## 平滑提速版测试

默认平移巡航为60 RPM；当前 X 型安装的路线和导航横移默认上限为60 RPM，转向默认上限为45 RPM，停车时可通过 `route tune F L T V` 设置10～120 RPM。平移采用三次曲线起步、制动距离速度包络和120 RPM/s速度变化限制；转向采用90 RPM/s速度变化限制、到位滞回。路线与导航平移的航向环采用PID：Kp=2.0、Ki=0.25、Kd=0.12（输出单位RPM）；积分限幅且饱和时不继续累积，微分取新IMU样本并滤波。横移纠偏按实际限速计算，并以90 RPM/s调整。匀速目标不重复发送同步命令；CAN仍保留四轮成组同步、发送失败停车和急停处理。

先确认 `IMU fresh`，每条动作命令之前单独发送 `arm`，等待回复后再发动作：

- `straight W 2000 40`：前进2秒，先检查起停是否平顺。
- `straight A 2000 40`、`straight D 2000 40`：左右平移各2秒。
- 确认后将末尾40改成60，比较横移效果。
- `turn L 90`、`turn R 90`：检查提速后的左右转与末端稳定性。
- 摆回启停区、车头朝上，`arm`后先用 `route auto 1 40` 或 `route auto 2 40` 低速验证，再按现场情况选择10～120 RPM。

原来的 `W/S/A/D` 是160脉冲的短点动，仍会走一下停一下；不能循环发送它们来判断连续运动是否顺滑。新的 `straight A/D` 才是平滑横移测试。`straight` 仍是定时测试，单位为毫秒，800 ms起止曲线会影响这段时间内的实际行程。

距离估计模型暂沿用原值，没有增加里程计或定位。横移提速后需重新测量横移距离比例。PID参数只是初值，先架空确认纠偏方向，再用低速短程实测并调参；超过20°偏差仍停车。软件测试覆盖加速度限制、左右横移、重复CAN指令过滤及2°附近噪声不会重复启停；实车平顺性仍需验证。若匀速段仍明显卡顿，应结合驱动器报警、供电和轮子受力检查。

这是两轮搬运的**底盘路线测试程序**。已安排扫码、两次原料、两次粗加工、两次暂存及回到原启停区的顺序，并加入IMU闭环旋转和连续跑圈命令。没有接入二维码识别、物料排序、机械臂流程、随机障碍检测或地面定位，因此还不是完整自主参赛程序。

## 新增：自动完整跑一遍

重新烧录本次 HEX，车体放在启停区1中心，车头朝地图上方；确认 `status` 显示 `IMU fresh`，逐条发送并等待回复：

```text
arm
route auto 1 40
```

启停区2使用 `route auto 2 40`。末尾速度参数可选，范围10～120 RPM；省略时默认60。该命令自动使能四轮，连续完成两轮路线和旋转，经过作业点不等待、不执行扫码/抓取、不需要 `route next`，到HOME停止。除故障或急停外，不会中途等待人工继续。

“连续”表示没有工位等待和固定300 ms转折等待；平移换向、原地旋转前仍会减速到零，旋转进入目标角度±2°后减速至零，以±3.5°作为退出到位状态的边界，稳定200 ms后自动进入下一动作，不是全程非零速度的圆弧行驶。

## 指定安全航点移动

把车体中心放在启停区 1 或 2、车头朝地图上方，确认 IMU 新鲜后先初始化：

```text
nav init 1
```

随后每次移动先发送 `arm`，再发送满足净空的地图坐标，例如移动到原料区：

```text
arm
nav goto 1200 2080 40
```

固件从当前估计位置接入静态安全航点图，选择确定性的最短轴向路径，不执行动态避障。末尾速度参数可选，范围10～120 RPM，省略时默认60。目标可以是地图范围内的任意整数坐标，但车体按300×300 mm计算后必须满足边界和障碍净空，并且能通过水平或垂直安全线段接入航点图；不安全或不可达坐标会被拒绝。既有二维码、原料、粗加工、暂存和启停区航点仍使用预设到达朝向，其他坐标保持当前朝向。`NAV POS` 和上位机地图显示均是命令积分估计，不代表实测位置。

任何停止或故障后都不得直接继续导航。应人工将车放回启停区、核对车头朝向并重新执行 `nav init`。

单独测试旋转：在远离边界、台面和障碍的空旷处发送 `arm`，再发 `turn L 90`（左转90°）或 `turn R 90`（右转90°）。参数范围1～180°，小于等于2°在到位容差内可能不产生旋转。角度相对于收到命令时的IMU读数。先测试90°左右转均正确，再运行整条路线；`!` 随时取消。

## 固件与接线

- 工程：本目录 `MecanumJog.uvprojx`；固件：`Objects/MecanumJog.hex`。
- 蓝牙 GC：电脑此前分配的传出端口 COM6（若重新配对，以当前端口列表为准），115200、8 数据位、无校验、1 停止位。
- 命令以文本发送，勾选发送新行（CR 或 LF）。每次只发送一条，收到回复再发下一条；不要开启循环发送。
- HWT101：USART2，PD6 接 IMU TX，接收波特率默认 115200。`status` 应显示 `IMU fresh`。
- 四轮：左前 ID2/前进0，右前 ID1/前进1，左后 ID3/前进0，右后 ID4/前进1。默认反向设置为0，trim=1000，yawdir=0。
- 轮径100 mm、轴距190 mm、轮距240 mm、车体300×300 mm、G=1、1.8°、16细分（3200脉冲/电机转）。

路线采用驱动器 RPM 速度命令，平移时保持当前目标IMU航向，走完本段距离后原地转向；平移方向根据车身当前朝向转换到四轮。旋转直接根据IMU角度闭环控制，默认上限45 RPM，接近目标时减速，不依靠轴距换算脉冲数。190/240 mm轮距用于验证预期角速度和转向超时范围，最终角度以IMU为准。四轮混合沿用原测试工程方向表，仍需在实车核对横移。

## 场地摆放

地图左下角为 (0,0)，右上角为 (2400,2400)，单位 mm；坐标指**车体中心**。启动时车头必须朝地图上方，即原料区所在的边，之后程序会控制转向。不要把车头朝向中心来启动。

- 启停区1：车体中心 (2250,2250)。
- 启停区2：车体中心 (2250,150)。

30 cm 车体与30 cm启停区同宽，起始摆放要准确。地图中间十字通道按400 mm、黄色方块按450 mm建模。测试场地必须先清空路径上的随机障碍。

启停区1和2分别使用两套完整且独立的20段距离表，修改一套的距离或朝向不会影响另一套。完整任务和路线联调使用逐段距离；表中方向为地图方向，车体前后/横移由当前车头朝向换算。每段从0累计已走距离，不读取全图X/Y；视觉对准后从实际停车位置继续下一段。距离仍是指令估算，须实测标定。独立的 `nav goto` 地图导航不属于这张距离表。

|序号|移动方向与距离（mm）|完成动作|
|---|---|---|
|1|区1向左200；区2向左150|保持朝上|
|2|区1向下1050；区2向上1050|转向右，QR扫码等待|
|3|区1向上830；区2向上825|出发前转向上，走完转向左|
|4|向左900|RAW_1取料，保持朝左|
|5|向左830（完整任务合并左右归位量）|保持朝左移动，走完转向下|
|6|向下1720|保持朝下移动，走完转向右|
|7|向右860|保持朝右，COARSE_1放置/回收|
|8|向左860|转向下|
|9|向上850|TEMP_1暂存，保持朝下|
|10|区1向上880；区2向上890|转向左|
|11|向右850|RAW_2取料，保持朝左|
|12|向左830（完整任务合并左右归位量）|保持朝左移动，走完转向下|
|13|向下1720|保持朝下移动，走完转向右|
|14|向右860|保持朝右，COARSE_2放置/回收|
|15|向左860|转向下|
|16|向上850|TEMP_2码垛，保持朝下|
|17|区1向上880；区2向下850|转向右|
|18|向右1700|保持朝右，向前直行|
|19|区1向上220；区2向下200|保持朝右，横移|
|20|向右150|保持朝右，向前直行，HOME结束|

两轮完整任务取料结束且机构归位后，只反向补偿地图上下视觉偏移（15 RPM），左右归位量分别合并到第5/12段左移：车头朝左时，实际左移距离为830 mm减去累计车体前进偏移（整数毫米）。无视觉偏移时，两轮均依次左移830 mm、转向下并下移1720 mm、转向右并右移860 mm到对应粗加工区；本次取料后左移较此前减少30 mm，下移减少20 mm，两轮均取消额外右移50 mm。后续路线、作业顺序和距离保持原值。

作业等待只适用于 `route start`；`route auto`跳过作业等待，`route step`每段都等待，`route mission`自动完成扫码等待、视觉及取放后继续。到位判定只看本段估算距离；转向仍由IMU闭环控制。原地转向的实际净空、滑移和终点均须实机核对，软件测试不能证明实际到达。

## 第一次测试：逐点停车

1. 烧录本次生成的 HEX。先架空底盘，确认 `!` 能停止，再落地。每次复位后路线都不自动启动。
2. 发送 `status`，确认 IMU fresh 和四个前进方向。分别发送 `cancheck 1` 至 `cancheck 4`，应都有返回；这些回复只证明通讯，不证明地面移动正确。
3. 在空旷处分别用 `arm` + `A`、`arm` + `D` 检查自动使能和左右横移是否正确。每条命令单独发送并等动作停止。
4. 把车摆回对应启停区，车头朝上。先以启停区1为例依次发送：

   ```text
   arm
   route step 1 40
   ```

   `route step 1` 自动使能四个底盘电机，启动第一段200 mm左移。不要整段粘贴连发，先等 `arm` 回复。
5. 每到一点都停车并显示 `WAIT`。测量实际车体中心，和表格比较。确认位置合理后，发送 `route next`，只继续到下一个点。第2点会沿右侧通道向下走1050 mm，要先留出这段空间。
6. `route status` 可随时查询路线状态与**估计坐标**；它显示的坐标不是实测坐标。WAIT时 point 指向下一目标编号。
7. 出现方向错误、碰撞风险或明显偏离立即发送 `!`（无需新行），或发送 `stop`。急停/停止会取消整条路线；重新开始前必须把车摆回启停区，不能在中途原地重发启动命令。
8. 每一点都核对完后，回到启停区，用 `arm`、`route start 1` 测试整条路线。此模式在 QR、RAW、COARSE、TEMP 点等待 `route next`，普通转折点自动继续。HOME 自动结束。
9. 启停区2对应 `route step 2` 或 `route start 2`。起点Y改为150，其余工位顺序相同。

WAIT期间允许原有 `servo` 命令，但不会自动执行机械臂动作。应等机械动作完全结束、物料已放稳，再发 `route next`。不要在等待时手动推动或转动车身后继续；如果发生移动，应取消路线并重新定位。

## 距离标定与现阶段限制

路线以100 mm轮径换算：每转理论314.159 mm，巡航60 RPM（约314 mm/s），起止降速。距离通过累计已发速度×时间估计；没有读取编码器位移，也没有外部XY位置反馈。IMU只能控制朝向，不能纠正横向滑移、轮径误差或打滑。使用 Qt 上位机的 `mecanum_jog 文本协议` 后，首次收到 `hb` 会启用通信看门狗，心跳中断超过1000 ms将请求停车并取消路线；未建立心跳的普通串口会话断开后仍不会自动停止。两种方式都必须保持现场可断电。

在 `route_plan.h` 中分别调整：

- `ROUTE_FORWARD_SCALE`：前后实际距离 / 原先预计距离。
- `ROUTE_LATERAL_SCALE`：左右实际距离 / 原先预计距离。

默认纵向为1.0289，横移为0.90。纵向来自已验证的 `line W 500 120`：9.9脉冲/mm对应3200 / 9.9 mm/转，再除以理论轮周314.159265 mm，得到约1.0289；500 mm位置移动对应4950脉冲。前进120 RPM已实测约500 mm，正式路线默认200 RPM及后退仍须复测。例如第一段预计左移150 mm而实测135 mm，将横移系数改成0.90后重新编译烧录，程序会用更长的运动时间补足预计距离。若已有系数，更新值 = 原系数 × 实测距离 / 目标距离。使用多次、双向、相同载荷与地面的测试均值；前后、左右误差不一致时，单一系数不足以解决，需要进一步定位与控制改进。

工位中心和尺寸在赛场会变化，本版沿用已调好的各段距离。分别调整 `routeDistanceZone1` 或 `routeDistanceZone2` 中的距离和朝向时，要重新实测车体净空和到站位置。随机障碍、地面定位、扫码和抓取完成信号接入后，才可把人工 `route next` 换成经过校验的自动事件。不能仅删除等待就称为自主参赛程序。

运动期间 IMU 超过250 ms未更新、平移航向偏差超过20°、控制间隔超过150 ms、单段平移超过45秒、一次旋转超过18秒或CAN发送失败会取消路线并尝试停车。旋转期间允许大于20°的目标角误差，到位进入阈值为±2°、退出阈值为±3.5°，转速降至零后稳定200 ms结束旋转。CAN发送成功不等于四个驱动器都执行成功；断线情况下停车命令也可能无法送达。

## 软件验证

`tests/test_route.c` 检查两种起点的距离表、单轴移动、工位数量、出发及到达朝向、四轮正负号、转向后的方向变换和速度单位。`tests/test_route_runtime.ps1` 用实际路线状态机运行理想电机/IMU模拟，检查两起点与两种IMU符号下的连续完成、±180°跨越、分段距离累计与清零、忽略任意全图坐标、逐段等待、取消、独立旋转、旋转超时及IMU断流停车。它们不模拟轮胎打滑、定位误差、相机或机械臂。最终距离和工位可达性必须通过上述实车测试确认。
