threebod/mecanum_jog/AVOIDANCE_TEST.md

# 区域记忆避障跑图

独立底盘测试路线：启停区 → 二维码点 → 原料 → 粗加工 → 暂存 → 原料 → 粗加工 → 暂存 → 原启停区。到扫码点后朝向右侧二维码板，停车等待扫码结果，再停稳 500 ms 后继续；其他工位停稳 500 ms，不执行取放。普通导航、距离表路线和完整任务保留原入口。

## 部署与使用

1. 用现有 Keil 打开本目录的 `MecanumJog.uvprojx`，编译并手动下载 `Objects/MecanumJog.hex`。不要下载参考工程 `yyb_stm32`。
2. 先将 `camera_code/K230/wifi_config.example.py` 复制为本地 `wifi_config.py` 并填写 Wi-Fi 配置；该文件被 Git 忽略。在 CanMV IDE 中上传 `camera_code/K230/` 下七个文件到板上同一目录：`避障跑图.py`、`avoidance_protocol.py`、`obstacle_detection.py`、`qr_protocol.py`、`camera_preview.py`、`obstacle_web.py`、`wifi_config.py`。先运行 `避障跑图.py`；上电运行时，将入口另存为 `main.py`，其余六个文件名不变。不同摄像头入口一次只运行一个。
3. UART1：IO9 TX → STM32 PB11 / USART3 RX，IO10 RX ← PB10 / USART3 TX，共地，115200、8N1，沿用现有 3.3 V 串口接线。
4. 打开上位机，选择 `mecanum_jog` 文本模式，进入“场地定位”的“避障跑图”组。车辆放在选定启停区中心，车头朝场地 +Y。起点沿用原导航：区 1 `(2250,2250)`、区 2 `(2250,150)`。选择起点和速度，再点击开始两轮。
5. 有线画面在 CanMV IDE 帧缓冲区查看；无线画面用浏览器打开终端打印的 `K230 preview: http://<实际IP>:8080/`。电脑和 K230 接入同一 Wi-Fi。`wifi_config.py` 已沿用现有独立无线预览的 Wi-Fi 配置，改网络时修改该文件的 `WIFI_SSID` 和 `WIFI_PASSWORD`。y=160 红线以上不检测黑块，扫码仍使用完整画面。

同一入口兼具扫码及避障。**默认不扫码，主控到达扫码点并停稳后发送扫码请求**；扫码使用完整 640×480 画面，上方 1/3 的黑块检测限制不影响二维码。读到码后保持 K230、摄像头、串口及 IDE 预览运行，收到主控停止扫码命令后只关闭二维码识别。无需运行第二个 `扫码.py`。此次须同步更新 STM32 固件以提供到点触发，K230 系统固件无需重刷。

无线网页显示同一帧的红线、检测框、框底部行、黑色像素数、距图底像素量、前沿距离/超范围、观察区和扫码状态。浏览器暂停或断开后相机仍持续检测与通信；网络等待使用非阻塞收发，每帧只推进一次，慢连接超过 300 ms 丢弃。Wi-Fi 尚未连上时继续执行摄像头和串口，连接成功后再打印网址。

停止避障并等最后请求过期（约 1.5 秒）后，可在网页调整 LAB 和像素门槛；运行中返回“请先停止避障跑图”。像素门槛最低 2200，与主控校验一致；调参重新累计稳定帧。参数只在此次运行有效，重启恢复入口默认值。无线帧率及 JPEG 压缩耗时需要实机验证，程序未保证固定刷新率。

正常完整任务在原 `MISSION_QR_WAIT` 停车状态触发扫码，沿用任务码格式校验。避障跑图在扫码点等待首个扫码结果（仅读取和显示，不执行任务码对应的机构动作）；未识别到码则保持停车，可使用停止或急停取消。

测试速度 **10～250 RPM，默认 30 RPM**，车轮混合、加减速和横移限速继续生效。250 RPM 是允许设置的上限，需从 30 RPM 开始实测识别延迟和停车距离，再逐档提高。位置为命令积分估计，软件模拟不能证明实际定位精度或停车距离。机构、方向及急停先按原测试步骤验证。

## 区域及规划

坐标原点在左下角，单位 mm。九区集中定义于 `avoidance_regions.h`，上位机地图直接复用该表。

| 编号 | 区域 | X | Y |
|---|---|---|---|
| R1 | 左上外围 | 0～550 | 1850～2400 |
| R2 | 左下外围 | 0～550 | 0～550 |
| R3 | 右上通道 | 1850～2400 | 1400～1850 |
| R4 | 右下通道 | 1850～2400 | 550～1000 |
| R5 | 十字上支路 | 1000～1400 | 1400～1850 |
| R6 | 十字下支路 | 1000～1400 | 550～1000 |
| R7 | 十字左支路 | 550～1000 | 1000～1400 |
| R8 | 十字右支路 | 1400～1850 | 1000～1400 |
| R9 | 中心交叉口 | 1000～1400 | 1000～1400 |

以航点和车头方向作 Dijkstra 状态，路线只含水平、垂直段；未知通道向前观察行驶。黄色区和工位实体禁止车体穿越，平移按 300×300 mm 车体检查，转向按约 212 mm 外接圆检查。

启停区的场地边缘航点只连接各自入口：区 1 `(2250,2250)↔(2100,2250)`，区 2 `(2250,150)↔(2100,150)`。出发先向场内横移 150 mm，再沿 `x=2100` 纵向行驶；返回最后从同一入口进入启停区。`x=2250` 不再作纵向通道，`y=150/2250` 不作横穿场地的通道。右侧通道按车体中心 x=2100、宽300计算，车体右沿2250，距离场地右边界2400有150 mm理论余量；这是地图净空，不是实测定位误差保证。

工位按用户给定条件不放随机障碍。**R3 封闭时仍允许在二维码工位转向**；工位转向仍检查场地边界和黄色区的静态净空。原料、粗加工、暂存也按此规则处理，现场须确认这些工位的实际旋转空间。

首次检出先停车，等待 300 ms，重新请求连续三帧稳定结果。根据估计车位、朝向、当前通道及纵向距离登记封闭区域，不保存精确障碍 XY。归属有歧义时保持停车，再停稳复检一次，仍有歧义则停止；超出标定范围直接停止。

登记后，只沿同朝向、共线且已走过的历史路径退回安全检查点，再重新规划原目标。无法安全退回或无路可走时保持停车，不跳过目标、不删除记录。当前不支持倒着跨越历史转角，该情况报告 `NO_SAFE_RETREAT`。

记忆保存在主控 RAM：停止、急停、两轮切换、再次启动及上位机重连均保留；停车后显式清空或主控复位才删除。改变障碍布局后先清空。内部避障暂停保留目标及进度，急停取消运行。重连只查询，不发送恢复运动命令。

## 相机参数及标定

LAB `(8,25,-14,10,-8,16)`；色块像素和包围框面积门槛均为 2200；ROI `(0,160,640,320)`。像素数是落入 LAB 阈值的色块像素，不是整个物体的面积。三帧稳定沿用现有中心波动确认。

固定 640×480，量为 `479 - 框底部y`，距离从车体前沿算起：

| 像素量 | 前沿距离 mm |
|---|---|
| 17 | 235 |
| 23 | 280 |
| 72 | 365 |
| 104 | 370 |
| 127 | 490 |

分段线性整数插值，范围外不外推；换算车体中心距离加 150 mm。当前没有横向毫米/像素标定，横坐标用于回包诊断，区域归属按车头中心方向和观察区域相互核对。侧方目标、边界目标和积分误差需实机验证。

## 命令与状态

启动先发 `arm`，再发送：

```text
avoid start 1 30
avoid stop
avoid status
avoid clear
```

区号仅 1/2，RPM 接受 10、30、250，拒绝 9、251。启动要求底盘和机构空闲、IMU 新鲜、CAN 正常；运行期间拒绝其他运动入口，复用心跳及 `!` 急停。清空只能在相关动作停止时执行。

主控报告示例：

```text
AV STATE state=MOVE active=1 round=1 target=RAW_1 region=3 blocked=4 replans=1 camera=1 x=2100 y=2080 yaw_cdeg=9000 reason=NONE
AV PATH_BEGIN version=2 count=2
AV PATH_POINT version=2 index=0 x=2100 y=2080
AV PATH_POINT version=2 index=1 x=1200 y=2080
AV PATH_END version=2
```

`blocked` 位 0～8 对应 R1～R9；`yaw_cdeg` 单位 0.01°；路径包含同位置的转向航点。上位机收齐同版本、顺序完整的快照后才更新路径；记忆以主控报告为准。

相机协议为带 CRC 的 ASCII：

```text
AVQ:token:region:confirm:CRC\n
AVR:token:region:seen:stable:u:bottom:pixels:CRC\n
QRQ:token:enabled:CRC\n
QR:原有二维码内容\n
```

CRC16 CCITT FALSE：初值 FFFF、多项式 1021，覆盖从 AVQ/AVR 首字节到最后一个数值，不含 CRC 前的冒号及换行；CRC 为四位大写十六进制。token 为 1～65535，region 为 0～9，0 只检查相机通信、不登记障碍。移动请求每 200 ms 更新编号，静止确认保持编号，区域/模式改变立即换号。seen=0 时 u/bottom/pixels 必须为 0；stable=1 可表示连续三帧未检出。

旧编号、区域不符、非法字段及错误 CRC 不刷新通信状态、不更新地图。初始化最长等待 1500 ms，运行中超过 500 ms 无有效回包停车。主要停止原因：`CAMERA_INIT_TIMEOUT`、`CAMERA_LOST`、`DISTANCE_RANGE`、`REGION_AMBIGUOUS`、`NO_SAFE_RETREAT`、`NO_PATH`、`HEADING_FAULT`、`CONTROL_FAULT`。

首次候选及停稳后的稳定检出额外打印 `AV OBS token=... region=... u=... bottom=... pixels=... gap=... front_mm=...`，日志在停车指令之后输出。`front_mm=-1` 为超范围；合法框底部行为 352～462。`DISTANCE_RANGE` 表示无法用当前标定换算距离，不等同于已确定误识别。先用画面检查是否框住阴影、车身或黑色标记；若确为障碍物且落在范围外，须补充实测标定，不能直接取消超范围拒绝。

`QRQ` 同样使用上述 CRC，enabled 为 0/1。主控只在扫码点停车时发送 enabled=1，并每 200 ms续发；收到结果或离开扫码点发送 enabled=0。K230 超过 700 ms 未收到有效扫码请求即停止二维码识别，但保留摄像头和避障。二维码按原 `QR:` 协议回传，未收到停止请求时同一内容至多每秒重发一次，避免结果丢失导致一直等待。扫码请求和避障请求共享串口解析器，不能把工位观察 region=0 当作到达扫码点。

## 离线验证

新增 CTest：`test_avoidance_core`、`test_avoidance_runtime`、`test_avoidance_ui`。覆盖 CRC、距离边界、两起点四朝向、两轮流程、R3 检出停车及安全退回、再次启动保留记忆、失联、清空限制、授权互斥及完整快照；实际固件桥接模拟也验证 250 RPM 下横移限速。

K230 命令：`python -B -m unittest discover -s test/mecanum_jog/camera_code/K230 -p 'test_*.py'`。31 项通过；覆盖 ROI、2200 门槛、红线、IDE 显示、三帧确认、CRC、仅到点请求才能扫码、全画面扫码、停止/过期请求后继续避障及短写清理。主控模拟核对扫码点车头朝右、停车等待结果、扫码开关请求及 CRC，以及正常完整任务扫码点触发。

完整 CTest 日志：`upper_computer/build/avoidance_ctest.log`，最后全量 32/37 通过，新增三项避障测试通过。Keil 日志：`avoidance_build.log`（0 错误、0 警告）。四项机构相关失败为任务云台角度、机构动作模型默认值、机构动作页面舵机速度、路线编辑器初始姿态校验；涉及本次未修改的参数与旧预期，未改写实际机构参数来凑测试通过。另外串口面板循环发送测试出现时序失败，曾单独复测通过，日志见 `upper_computer/build/avoidance_serial_panel_recheck.log`。

尚未烧录或进行车辆实机验证。

2026-10-13 扫码接入验证：Keil 编译 0 错误、0 警告，日志 `qr_avoidance_build.log`；固件仍为 `Objects/MecanumJog.hex`。本次完整 CTest 33/37 通过，四项已有机构相关失败保留，日志 `upper_computer/build/qr_avoidance_ctest.log`。实际 QR 解码耗时、扫码板可见范围及与相机 500 ms 通信保护的配合须实机确认。

2026-10-13 无线与诊断接入：相机 Python 40 项测试通过，包含真实本地 TCP 收发、分片请求/响应、网络堵塞逐帧返回、300 ms 连接超时、停车调参和主循环诊断字段。完整 CTest 33/37 通过，四项已有机构相关失败保留，日志 `upper_computer/build/wireless_avoidance_ctest.log`。Keil 0 错误、0 警告，日志 `wireless_diagnostics_build.log`；`Objects/MecanumJog.hex` 新增 AV OBS 日志。未实机验证新无线入口的 JPEG 兼容性、刷新率及无线干扰下的通信时延。

2026-10-13 场地边缘航线修正：两起点四朝向均验证先经过 x=2100 的原入口，返回也经过各自入口；普通通道不沿 x=2250 或 y=150/2250 贴场地边缘行驶。九区及组合封闭、无可达路线、退回、两轮记忆和扫码朝向测试通过。Keil 0 错误、0 警告，日志 `avoidance_inner_lane_build.log`。完整 CTest 33/37 通过，四项已有机构失败保留，日志 `upper_computer/build/avoidance_inner_lane_ctest.log`。固件仍为 `Objects/MecanumJog.hex`，须下载新版并从30 RPM验证实际出入口位置。
