threebod/mecanum_jog/camera_code/vision_settings.py

UART_DEVICE = "/dev/ttyS4"
UART_PINS = {"A21": "UART4_TX", "A22": "UART4_RX"}
BAUD = 9600

COLOR_THRESHOLDS = {
    1: [30, 80, 55, 105, 25, 80],
    2: [50, 105, -30, 25, 35, 100],
    3: [17, 37, 8, 32, -59, -35],
    4: [50, 100, -100, -50, 20, 80],
    5: [8, 25, -14, 10, -8, 16],
    6: [50, 84, -27, -3, -36, -12],
}
MATERIAL_AREA = (1500, 30000)
RING_CONTRAST = 80
# Image-processing parameters are defined for 640x480 input.
RING_SHARPEN_AMOUNT = 1.0
RING_SHARPEN_SIGMA = 3.0
RING_BINARY_BLOCK = 21
RING_BINARY_C = 10
RING_MIN_CIRCULARITY = 0.5
# Geometry uses the vehicle's 320x240 protocol coordinates.
RING_CENTER_TOLERANCE = 4
RING_MIN_RADIUS = 25
RING_MAX_RADIUS = 80
RING_MIN_CONTOURS = 2
RING_TARGET_COUNT = 3
RING_DIGIT_ROI_RATIO = 0.44
RING_DIGIT_MIN_SCORE = 0.60
RING_DIGIT_SCORE_MARGIN = 0.10
