threebod/mecanum_jog/vision_defaults.h

#ifndef VISION_DEFAULTS_H
#define VISION_DEFAULTS_H

#define VISION_MATERIAL_FORWARD_MILLI 640
#define VISION_MATERIAL_RIGHT_MILLI   673
/* User-confirmed ring 2 scales: forward 1.111, right 1.143 mm/pixel. */
#define VISION_RING2_FORWARD_MILLI    1111
#define VISION_RING2_RIGHT_MILLI      1143

#endif
