threebod/mecanum_jog/jog_can.h

#ifndef JOG_CAN_H
#define JOG_CAN_H

#include <stdint.h>

typedef struct {
    uint32_t extId;
    uint8_t dlc;
    uint8_t data[8];
} JogCanReply;

/* 0: interrupted, 1: reply received, 2: timed out. */
uint8_t jogCanReadStatus(uint8_t motorId, const volatile uint8_t *stopRequested,
                         JogCanReply *reply);

#endif
