threebod/mecanum_jog/(commit log)

2026-09-09 feat: add motor 5 diagnostic jog commands
2026-09-09 feat: add motor 5 CAN diagnostics
2026-09-09 feat: add servo serial controls
2026-09-13 Summary
    增加底盘直线测试和IMU航向保持
2026-09-13 路线测试
    依据地图路线测试
2026-09-13 路线测试2
    加入旋转与完整路线一次跑通
2026-09-13 优化移动
    提高转速，优化转弯
2026-09-15 实现全图移动
2026-09-15 feat: add selectable motion speed and motor 6 jog
2026-09-16 fix: report mechanism estimated progress
    [main.c, mechanism_action.h, test_mechanism_action.c]
2026-09-16 fix: calibrate lateral navigation distance
    [route_plan.h, test_route.c]
2026-09-16 put objects
    新增摄像头与机械联动
2026-09-16 camera
    摄像头代码
2026-09-26 feat: add heading PID tuning for mecanum navigation
2026-09-26 refactor: split IMU and CAN diagnostics from main
2026-09-27 feat: stream navigation heading PID telemetry
2026-09-27 feat: add lateral heading PID test motion
2026-09-27 feat: expand heading PID gain range
2026-09-27 fix: align mecanum jog mapping with X wheel layout
    [main.c, route_plan.h, test_route.c]
2026-09-27 fix: face right-side arm toward route stations
    [map_navigation.h, route_plan.h, test_navigation.c, test_route.c]
2026-09-27 feat: add camera-guided vision alignment
2026-09-29 feat: run two-round camera-guided pickup mission
2026-09-29 fix: correct material platform slot angles
    [raw_pick_action.h]
2026-10-01 feat: optimize mission actions with motor arrival feedback
2026-10-01 fix: restore estimated action timing without settle delay
    [jog_can.c, jog_can.h, main.c, mechanism_action.h, test_can.c, test_mechanism_action.c]
2026-10-09 feat: update camera vision code
2026-10-13 chore: exclude generated outputs and local camera credentials
2026-10-13 feat: integrate camera detection and preview workflows
    Group K230 QR, obstacle detection and browser preview sources with a local Wi-Fi configuration example. Update MaixCAM material and ring detection, protocol handling, and focused tests.
    Validation: MaixCAM unittest 52/52; K230 unittest 40/40. Preserve the current physical detection thresholds.
2026-10-13 feat: synchronize camera-assisted mission control
    Integrate region-memory avoidance, camera request handling, route execution and the current mechanism action tables. Update firmware runtime tests and deployment notes for the matching robot-tuner application.
    Protocol and calibration parameters changed. Current physical parameters were confirmed as hardware-validated by the project owner. This preparation did not flash or operate hardware.
    Validation: Keil 0 errors / 0 warnings; integrated CTest 38/38; contract, mechanism timing, turret and obstacle-stop tests passed.
2026-10-14 chore: checkpoint before three-material alignment
