threebod/mecanum_jog/(notices)

Notices in the files:
snapshots/pre-material-layout-20261015/yyb_stm32/SYSTEM/delay/delay.c:
Copyright(C) ¹ãÖÝÊÐÐÇÒíµç×Ó¿Æ¼¼ÓÐÏÞ¹«Ë¾ 2014-2024
All rights reserved
